doyouemo/antenna/README.md

# antenna
record how the PCB antenna draw
