doyouemo/antenna/Document/nrf52833_aoa_aod_hw_design.md

# nRF52833 BLE AoA/AoD 定位板 硬件设计文档

| 项目 | 内容 |
|---|---|
| 文档版本 | v0.1（初稿） |
| 日期 | 2026-08-10 |
| 状态 | 设计评审前 |
| 芯片 | NRF52833-QIAA（aQFN73, 7×7mm） |
| 方案 | BLE 5.1 CTE 方向定位，AoA/AoD 双角色 |

---

## 1. 项目概述

本板为基于 Nordic **nRF52833** 的蓝牙方向定位（Direction Finding）评估/产品板：

- 支持 **BLE 5.1 AoA（来波角度）**：作为定位基站，用 **3×4 = 12 单元天线阵列**测来波方向；
- 支持 **AoD（出射角度）**：同一射频链路切到发射模式，作为标签让对端（手机等）测出射方向；
- 调试/日志采用 **CH340N**（USB 转串口，内置晶振）提供独立 UART 日志口 + **RTT**（SEGGER，走 SWD）实时调试；
- 按 **Config 5** 参考电路设计：启用内部 DC/DC 省电、启用 nRF 内置 USB 与 NFC；
- nRF 内置 USB（D+/D−、VBUS/VDDH）与 NFC（NFC1/NFC2）引脚**引出到排针/测试点**，便于后续使用。

## 2. 设计指标

| 项目 | 指标 | 备注 |
|---|---|---|
| 协议 | BLE 5.1，支持 CTE | 2.4GHz |
| 方向定位 | AoA / AoD 双角色 | 固件模式切换 |
| 天线阵列 | 3×4 微带贴片，12 单元 | 中心距 ≈ 半波长 ≈ 61mm |
| CTE 采样 | 4 MHz I/Q 采样 | 每天线 1µs 采样 |
| 天线切换 | 1µs 切换 + 1µs 采样 | RF 开关切换时间 < 1µs |
| 日志/调试 | CH340N UART + RTT(SWD) | 详见 §12 |
| 供电 | USB 5V → 3.3V | 可选电池 + 内部 DCDC |
| 工作电压 | 1.7–3.6V（VDD） | |

## 3. 系统框图

```
                    ┌──────────────────────────────┐
                    │    3 × 4 微带贴片阵列（12）    │
                    │    中心距 61mm（≈λ/2）        │
                    └───┬────┬────┬────┬──────────┘
                        │    │    │    │   12 根馈线(等长/相位对齐)
                 ┌──────┴───┐ ┌──┴────┐
                 │ SP4T ×3  │ │ ……     │   第一级开关（3×SP4T）
                 └──────┬───┘ └───┬───┘
                        │   3 路合并 │
                    ┌───┴───────────┴───┐
                    │     SP4T ×1        │   第二级开关
                    └─────────┬─────────┘
                              │ ANT (H23)
                      ┌───────┴───────┐
                      │   nRF52833     │
                      │  (QIAA/aQFN73) │
                      └──┬────┬────┬──┘
                         │    │    │
            ┌────────────┘    │    └────────────┐
            │  SWD(RTT)     3.3V        UART TX/RX
        ┌───┴───┐      ┌────┴────┐      ┌──────┴──────┐
        │ J-Link│      │ 电源 DCDC │      │   CH340N    │
        │烧录+RTT│     │ →3.3V   │      │  (USB-UART)  │
        └───────┘      └─────────┘      └──────┬──────┘
                                               │
                                        USB-C 调试/日志口
```

## 4. 总体架构

- **射频路径**：ANT(H23) → 两级 RF 开关树 → 12 个贴片阵元。天线切换由 nRF 的 **PPI + GPIOTE + TIMER** 硬件时序驱动（与 CTE 时隙对齐），不占用 CPU。
- **数字路径**：nRF52833 的 UARTE 接 CH340N，CH340N 经 USB-C 输出虚拟串口；SWD 接 J-Link 用于烧录与 RTT；nRF 内置 USB（D−/D+）与 NFC 引脚引出备用。
- **角色切换**：同一硬件，固件按模式配置芯片为 CTE 接收（AoA locator）或 CTE 发射（AoD transmitter）。

## 5. 主要器件选型

| 器件 | 推荐型号 | 说明 |
|---|---|---|
| MCU | **nRF52833-QIAA-R** | aQFN73，BLE 5.1 DF |
| USB 转串口 | **CH340N** | SOP-8，内置晶振，3.3V 供电 |
| RF 开关(SP4T) | **SKY13322-375LF**（或等效） | 4 选 1，切换时间 ~几十 ns |
| RF 开关(SPDT 备用方案) | SKY13351-378LF | 全 SPDT 树方案时用 |
| 32MHz 晶振 | 标准 32MHz，±10ppm | XC1/XC2 |
| 32.768kHz 晶振 | 标准 32.768kHz，±20ppm | P0.00/P0.01，**必须接** |
| 电源 DCDC | **TPS62742**（TI） | 5V→3.3V，低静态电流 |
| USB 连接器 | USB Type-C（仅 USB2.0 信号） | 调试/日志口 |
| ESD 保护 | USBLC6-2SC6 | USB D+/D− |
| 内部 DCDC 电感 | **L3 = 10µH**（DCC 脚） | Config 5 启用内部 DC/DC |
| 内部 DCDC 滤波 | **L4 = 15nH、C15 = 47nF、C20 = 4.7µF** | DC/DC 相关滤波 |
| NFC 调谐电容 | Ctune1 / Ctune2（天线决定） | NFC 天线匹配 |

> 选型说明：RF 开关具体型号以现货与规格书为准，重点是**切换时间 < 1µs**、插损小、2.4GHz 性能好。

## 6. 原理图设计要点

### 6.1 nRF52833 电源与去耦

- **VDD**：3.3V，就近放 100nF + 10µF 去耦。
- **DCC**（B3）：内部 DC/DC 开关节点，接 **L3 = 10µH 电感**到 VDD。固件使能 DCDCEN（Config 5）。
- **DEC1/DEC3/DEC5**：稳压器去耦电容（100nF 级）。
- **DEC4(B5) 与 DEC6(E24)**：**必须用走线连在一起**，各放去耦电容。
- **VDDH(Y2)**：**接 VBUS(5V)**——启用 nRF 内置 USB 时，VBUS 必须接 VDDH 供 USB 稳压器（2.5–5.5V）。
- **DECUSB(AC5)**：USB 3.3V 稳压器去耦，接去耦电容到地（Config 5 USB 启用）。
- **VSS_PA(F23)**：射频地，就近打孔到主地。
- **底部焊盘**：必须接地。

> 具体电容数值**以规格书 “Supply pin decoupling” 表为准**，本表为典型参考值。

### 6.2 晶振

- **32MHz**：XC1/XC2 接 32MHz 晶振，负载电容按晶振 datasheet（典型 2×10~12pF）。
- **32.768kHz**：P0.00( XL1) / P0.01( XL2) 接 32.768kHz 晶振，负载电容典型 2×12pF。**必须接**（BLE 时序 + DF 功耗，见 §14）。
  - 占用 P0.00/P0.01，不能当 GPIO 用。

### 6.3 天线与 RF 开关树

两级 SP4T 树，实现 **1-of-12** 选择：

```
第一级:  3 × SP4T   → 每个开关接 4 个阵元（共 12）
第二级:  1 × SP4T   → 3 路第一级输出选 1（用 4 口中 3 口）
控制线:  3×2 + 2 = 8 根 GPIO
```

- 控制线接 nRF GPIO（见 §7），由 **PPI/GPIOTE 硬件**按 CTE 时序翻转。
- **ANT(H23) → 开关树**之间为 50Ω 走线。
- 开关供电电压要与控制电平匹配（典型 3.3V/1.8V，看型号）。

### 6.4 CH340N 串口电路

```
USB-C ──D+ ──22Ω/ESD── CH340N UD+
       └─D− ──22Ω/ESD── CH340N UD−
5V VBUS ──────────────→ DCDC → 3.3V → CH340N VCC
CH340N RXD ←── nRF TXD (P0.08)
CH340N TXD ──→ nRF RXD (P0.11)
CH340N RTS#/DTR# : 悬空（本板不需要自动复位/下载）
```

- CH340N **内置晶振**，无需外接晶振与负载电容。
- CH340N 3.3V 供电，I/O 电平 3.3V，与 nRF 直连。
- D+/D− 加 **22Ω 串联**和 **ESD 保护**。

### 6.5 SWD 调试接口（RTT）

- 引出 **SWDIO + SWDCLK + VDD + GND**（建议标准 4-pin 或 10-pin 排针）。
- 建议同时引出 **P0.18/nRESET**（复位与全功能调试）和 **P1.00/SWO**（可选）。
- RTT 复用 SWDIO/SWDCLK，烧录与 RTT 可同时使用。

### 6.6 复位、按键、LED

- **nRESET**：上电复位电路（RC 复位 + 调试器复位可选）。
- **按键**：P0.13，用于角色切换（AoA/AoD）或配置。
- **LED×2**：P0.05 / P0.06 状态指示。

### 6.7 nRF 内置 USB（引出）

- **D−（AD4）/ D+（AD6）**：引出到排针/测试点（后续可接第二个 USB 连接器）。
- **VBUS（AD2）/ VDDH（Y2）**：VDDH 接 VBUS(5V)，从引出的 VBUS 测试点取电或跳线接主 5V。
- **DECUSB（AC5）**：接去耦电容。
- 与 CH340N 的 USB 相互独立，两者可共存。

### 6.8 NFC（引出）

- **NFC1（P0.09）/ NFC2（P0.10）**：接 NFC 天线，引出至焊盘/排针。
- 天线端加 **Ctune1/Ctune2 调谐电容**（值随天线定）。
- 启用 NFC 后 P0.09/P0.10 不可当 GPIO。

## 7. 引脚分配表

| 功能 | 引脚 | 方向 | 说明 |
|---|---|---|---|
| 32.768kHz 晶振 | P0.00 / P0.01 | — | XL1/XL2，专用 |
| 32MHz 晶振 | XC1 / XC2 | — | 专用 |
| ANT | H23 | RF | 射频口 → 开关树 |
| SW_A0 / SW_A1 | P0.27 / P1.08 | O | SP4T-1 控制（高速脚） |
| SW_B0 / SW_B1 | P0.04 / P1.09 | O | SP4T-2 控制（高速脚） |
| SW_C0 / SW_C1 | P0.26 / P1.07 | O | SP4T-3 控制 |
| SW_D0 / SW_D1 | P0.24 / P0.23 | O | SP4T-4（第二级）控制 |
| UART_TX | P0.08 | O | → CH340N RXD |
| UART_RX | P0.11 | I | ← CH340N TXD |
| SWDIO / SWDCLK | AC24 / AA24 | I/O | 烧录 + RTT |
| nRESET | P0.18 | I | 复位（可选引出） |
| SWO | P1.00 | O | 调试跟踪（可选） |
| LED1 / LED2 | P0.06 / P0.05 | O | 状态灯 |
| 按键 | P0.13 | I | 角色切换/配置 |
| NFC1 / NFC2 | P0.09 / P0.10 | — | **NFC 天线**（引出）；启用 NFC 后不可当 GPIO |
| USB D− / D+ | AD4 / AD6 | — | nRF 内置 USB（引出，专用脚） |
| VBUS / VDDH | AD2 / Y2 | — | nRF USB 电源：VDDH 接 VBUS(5V) |

**未分配/可用 GPIO（预留）**：P0.02, P0.03, P0.07, P0.12, P0.14–P0.17, P0.19–P0.22, P0.25, P0.28–P0.31(AIN), P1.01–P1.06。

## 8. 天线阵列设计

- **类型**：微带贴片天线（PCB 蚀刻），3 列 × 4 行。
- **中心距**：≈ 半波长 ≈ **61mm**（2.44GHz），两方向一致。
- **阵元尺寸**：约 30mm 见方（取决于板材 εr/厚度，**以仿真为准**）。
- **地平面**：贴片下层必须**完整地平面**，天线区禁止铺铜开槽/走线/器件。
- **馈电**：每阵元边缘馈电，50Ω 馈线引出；**12 根馈线等长、对称**，避免引入额外相位差。
- **隔离度**：阵元间尽量 >10dB，必要时用过孔墙/地槽。
- **阵列占板**：含地缘约 **170mm × 230mm** 以上，建议独立天线板与主控分板，或单大板。

## 9. 电源设计

- **输入**：USB 5V（来自调试口 VBUS）或外部 3.3V。
- **5V → 3.3V**：TPS62742 DCDC，输出 3.3V 供 nRF VDD、CH340N 及开关。
- **内部 DCDC（Config 5）**：DCC 接 **L3 = 10µH** 电感到 VDD，固件使能 DCDCEN，降低 3.3V→1.3V 降压损耗。
- **电池模式（可选）**：电池直供 VDD（1.7–3.6V）；3.3V LDO 供 CH340N 或断电。
- 各 DEC/VDD 去耦就近放置。

## 10. PCB 布局与叠层

**叠层（4 层）**：

| 层 | 用途 |
|---|---|
| L1 | 信号（贴片天线、走线） |
| L2 | 完整地平面 |
| L3 | 电源/地分割 |
| L4 | 信号/背面 |

- 天线区置于板边/独立板，**正反面净空**，地缘完整。
- ANT→开关→馈线全部 **50Ω 阻抗**（L1 到 L2 参考，注意线宽/间距）。
- 开关树靠近 ANT 与阵列馈电点，减少走线长度。
- 晶振、DCDC、RF 部分各自就近地，避免开关电源噪声串入射频。
- 8 根开关控制线从 nRF 到开关，尽量等长、短走线。

## 11. 调试与日志方案

| 手段 | 用途 | 说明 |
|---|---|---|
| **RTT** | 实时日志、时序敏感打印 | 走 SWD，需 J-Link；开发阶段主力 |
| **CH340N UART** | 独立串口日志 | 不依赖 nRF 固件/USB 驱动，崩溃时仍可出日志 |

日志输出建议：
- 开发期：RTT 打印 AoA 采样、角度、状态机；
- 联调期：CH340N UART（115200 或 1Mbps）输出结构化日志。

## 12. BOM 清单（关键件）

| 序号 | 器件 | 型号 | 数量 | 备注 |
|---|---|---|---|---|
| 1 | MCU | nRF52833-QIAA-R | 1 | |
| 2 | USB-UART | CH340N | 1 | SOP-8 |
| 3 | RF 开关 | SP4T（如 SKY13322-375LF） | 4 | 或 SPDT 树方案 |
| 4 | 晶振 32MHz | ±10ppm | 1 | |
| 5 | 晶振 32.768kHz | ±20ppm | 1 | 必须 |
| 6 | DCDC | TPS62742 | 1 | 5V→3.3V |
| 7 | USB-C | Type-C 连接器 | 1 | USB2.0 信号 |
| 8 | ESD | USBLC6-2SC6 | 1 | USB D+/D− |
| 9 | DC/DC 电感 | 10µH（L3） | 1 | DCC→VDD |
| 10 | DC/DC 滤波 | 15nH（L4）+ 47nF（C15）+ 4.7µF（C20） | 各 1 | Config 5 |
| 11 | NFC 调谐 | Ctune1 / Ctune2 | 2 | NFC 天线匹配 |
| 12 | 天线 | PCB 贴片 | 12 | 板载蚀刻 |

## 13. 风险与注意事项

1. **板载阵列相位一致性**是最大风险：依赖蚀刻公差、地平面、互耦。**必须做阵列相位校准**（nRF 有校准例程），量产建议按批校准。
2. **P0.09/P0.10 用作 NFC**：启用 NFC 后不能当 GPIO；日后若要改当 GPIO，需在 UICR 配置 `NFCPINS` 禁用。
3. **32.768kHz 晶振不能省**：LFRC（内置 RC，±250ppm）会导致 BLE 时序超标、DF 监听功耗大幅上升。
4. **开关树 8 根控制线的时序**：由 PPI/GPIOTE/TIMER 硬件翻转，1µs 切换 + 1µs 采样的时序余量务必在固件侧验证。
5. **DECUSB / VDDH**：Config 5 USB 启用，DECUSB 去耦按规格书接好；**VDDH 必须接 VBUS**，漏接会导致 USB 稳压器无法工作。
6. **贴片尺寸与间距需仿真**：文档中为典型参考，最终以 HFSS/CST 仿真与实物校准为准。

## 14. 后续工作

- [ ] 细化 RF 开关选型（现货、插损、控制电平）
- [ ] 阵列贴片天线仿真（尺寸、间距、隔离度）
- [ ] 完成原理图（基于本文档 §6/§7）
- [ ] PCB 布局与阻抗控制（§10）
- [ ] 固件：nRF Connect SDK `direction_finding_connectionless` 示例验证
- [ ] 验证 nRF 内置 USB（CDC）与 NFC 功能
- [ ] 阵列相位校准流程建立
