doyouemo/antenna/Document/Design of Inset Microstrip Patch Antenna for Wireless Power Transmission at 2.45 GHz.pdf

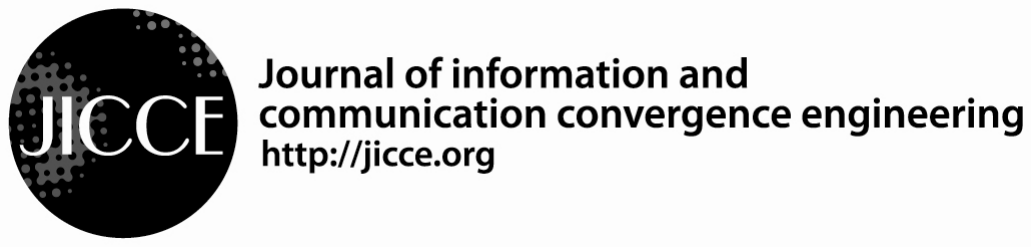
[picture p1: figure]

123

### I. INTRODUCTION

Wireless communication has been developed rapidly in the past decades and it already has a great impact on human life. In the field of wireless communications, antennas play a vitally important role. In the late 1970s, there was rapid development in the field of microstrip patch antenna technology. In early 1980s, antenna elements and arrays were developed in terms of design and modeling. Due to their advantages like light weight, reduced size, low cost, conformability, and the ease of integration with an active device, these antennas have been extensively studied. A microstrip patch antenna is the combination of a radiating patch on one side of the dielectric substrate and ground on the other side. The patch is generally made of a conducting material like gold or copper. The radiating patch and the feed lines are usually photo etched on the dielectric substrate. Microstrip patch antennas radiate primarily because of the fringing fields between the patch edge and the ground plane. Therefore, the antenna can be fed by a variety of methods. These methods can be classified into two categories: contacting and non-contacting. In the contacting method, the radio frequency (RF) power is fed directly to the radiating patch using a connecting element such as a microstrip line or probe feed. In the non-contracting method, electromagnetic field coupling is performed to transfer power between the microstrip line and the radiating patch which includes proximity feeding and aperture feeding [1, 2].
Microstrip antennas are characterized by a large number of physical parameters. They are designed to have many geometrical shapes and dimensions but rectangular and circular microstrip patches have been used in many applications. In this paper, the design of an inset feed rectangular microstrip patch antenna at 2.45 GHz for wireless communication is presented having length L, patch
J. lnf. Commun. Converg. Eng. 10(2): 123-128, Jun. 2012 | Regular Paper

# Design of Inset Microstrip Patch Antenna for Wireless Power Transmission at 2.45 GHz

Sajina Pradhan¹

, Sun-Kuk Noh²

, and Dong-You Choi¹*

1
Department of Information and Communication Engineering, Chosun University, Gwangju 501-759, Korea 2
Department of Electronics Engineering, Chosun University, Gwangju 501-749, Korea

### Abstract

In communication systems, there are various types of microstrip antenna that can be used for many applications. This paper mainly focuses on the simple design of an inset rectangular microstrip patch antenna to operate at a frequency of 2.45 GHz for rectenna design. The study involves using an high frequency structure simulator to design the antenna dimensions and to determine its performance. This antenna is based on a thickness of 1.6 mm flame retardant 4 (FR-4) substrate having a dielectric constant of approximately 4.7, an inset feed, and a ground plane. After simulation, the antenna performance characteristics such as its return loss, voltage standing wave ratio, gain, and radiation pattern were obtained and compared with the fabricated measured antenna.

Index Terms: Microstrip patch antenna, Inset feed technique, Radiation pattern, Wireless communication

___________________________________________________________________________________________

Received 06 March 2012, Revised 06 April 2012, Accepted 09 April 2012
*Corresponding Author E-mail: dychoi@chosun.ac.kr
http://dx.doi.org/10.6109/jicce.2012.10.2.112 | print ISSN:2234-8255 online ISSN:2234-8883

This is an Open Access article distributed under the terms of the Creative Commons Attribution Non-Commercial License (http://creativecommons.org/li-censes/by-nc/3.0/) which permits unrestricted non-commercial use, distribution, and reproduction in any medium, provided the original work is properly cited.

Copyright ⓒ The Korea Institute of Information and Communication Engineering

Open Access

J. lnf. Commun. Converg. Eng.10(2): 123-128, Jun. 2012

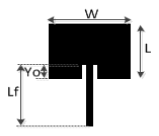
[picture p2: figure]

http://dx.doi.org/10.6109/jicce.2012.10.2.123 | 124

width W, inset fed distance Yo, and transmission line length Lf, as shown in Fig. 1. This antenna is designed on flame retardant 4 (FR-4) substrate and its performance characteristics, which include return loss, voltage standing wave ratio (VSWR), gain, and radiation pattern, were obtained from a simulation.

Fig. 1. Inset rectangular microstrip patch antenna.

### II. ANTENNA GEOMETERY AND ITS DESIGN REQUIREMENTS

For a rectangular patch, the length L of the patch is usually 0.333 λο , where λο is the free space wavelength. The patch is selected to be very thin, such that the height of the substrate h << λο . Thus, a rectangular patch of dimensions 36.26 × 27.90 mm is positioned on one side of an FR-4 substrate of thickness 1.6 mm, and the ground plane with dimension of 150 × 150 mm is located on the other side of the substrate.
There are three essential parameters for the design of an inset fed rectangular patch antenna. They are resonant frequency (fr), dielectric material of the substrate (εr), and the thickness of the substrate. The resonant frequency selected for this design is 2.45 GHz.
The dielectric material of the substrate selected for this design is FR-4, which has a dielectric constant of the 4.7 and a loss tangent equal to 0.019. The dielectric constant of the substrate material is an important design parameter. A low dielectric constant of the substrate material is used in the prototype design because it gives better efficiency, a higher bandwidth, and a low quality factor Q. The low value of the dielectric constant increases the radiated power. The design has a patch size independent of the dielectric constant. Therefore, the reduction in the patch size is accomplished by using a higher dielectric constant and FR-4 is good in this agreement. The small loss tangent was neglected in the simulation.
The thickness of the substrate is another important design parameter. The thickness of the substrate increases the fringing field at the patch periphery like the low dielectric constant and increases the radiated power. The height of the dielectric substrate of the inset microstrip patch antenna is h = 1.6 mm.

### III. MATHEMATICAL CALCULATION OF THE ANTENNA PARAMETERS

The parameters of the antenna can be calculated by the transmission line method.

### A. Width of the Patch

The width of the antenna can be determined by

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
⎛ + = W | r λο ε | (1)

### B. Length of the patch

The effective constant can be obtained by

2

1
12 1

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
⎛ − +⎟
⎟
⎠

⎞ ⎜
⎜
⎝

⎛ + =

W

h

r | r eff
ε | ε
ε | (2)

where
eff ε = elective dielectric constant
r ε = dielectric constant of substrate
h = height of dielectric substrate
W = width of the patch

The dimensions of the patch along its length have n ow been extended on each end by a distance ΔL , whic h is given by
( | )
( | ) | ⎟ ⎠
⎞ ⎜
⎝
⎛ − | +

⎟
⎠

⎞ ⎜
⎝

⎛ + +
Δ =
0.258 | 0.8
0.3 | 0.264
0.412
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
The actual length L of the patch is given by

L
f

L

r | eff
= | − 2Δ
2

1
ε

(4)

Where fr is the resonance frequency.

### C. Inset Feed

The inset feed introduces a physical notch, which in

Design of Inset Microstrip Patch Antenna for Wireless Power Transmission at 2.45 GHz

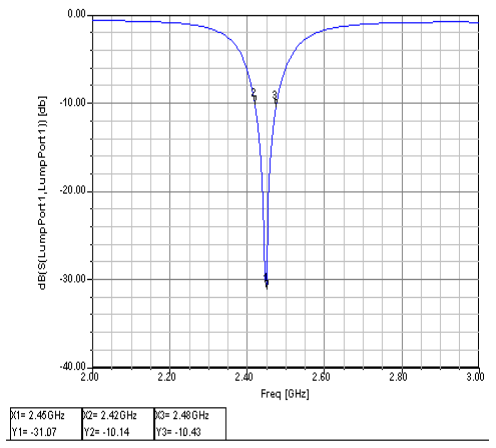
[picture p3: figure]
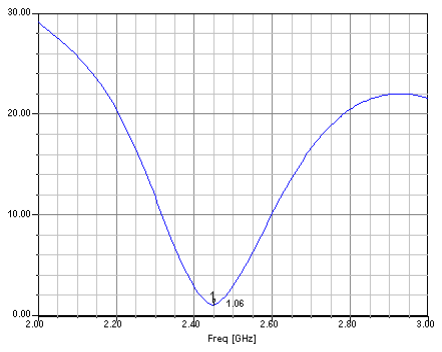
[picture p4: figure]

125 | http://jicce.org

turn introduces a junction capacitance. The physical notch and its corresponding junction capacitance influence the resonance frequency. As the inset feed-point moves from the edge toward the center of the patch, the resonant input impedance decreases monotonically and reaches zero at the center. When the value of the inset feed point
approaches the center of the patch, | 0 2 | y L
Cos Π | where 0 y

is the inset distance, which varies very rapidly; therefore, the input resistance also changes rapidly with the position of the feed point. To maintain very accurate values, a close tolerance must be preserved [3-5]. In this paper, the value of the inset-fed distance 0 y is 7.5 mm and the length and width of the transmission line at 50 Ω are 32 mm and 3 mm, respectively.

### IV. SIMULATION AND MEASUREMENT RESULTS

The antenna was simulated in high frequency structure simulator (HFSS), which is a high performance full-wave electromagnetic (EM) field simulator for arbitrary 3D volumetric passive devices, with a Microsoft Windows graphical user interface. The antenna designed in the HFSS simulator is shown in Fig. 2.

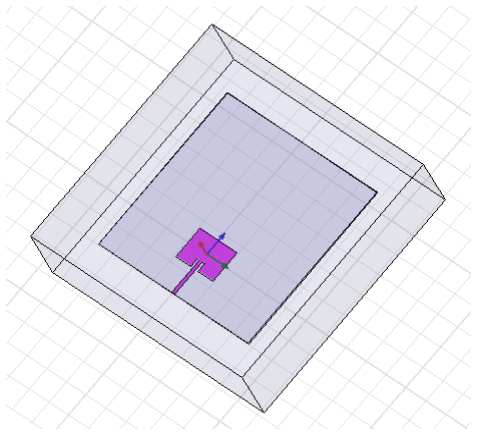
[picture p5: figure]

Fig. 2. Antenna in high frequency structure simulator.

The simulated return loss of the inset-fed antenna is -31.07 dB at the center frequency of 2.45 GHz as shown in Fig. 3.

The bandwidth of the antenna as a percentage is defined by

*100% max min
rf
f | f BW | − = | (5)

Fig. 3. Return loss vs. frequency.

where max f | and min f | are determined at -10 dB. rf is
the resonance frequency. The simulated value at -10 dB, max f = 2.48, min f = 2.42, and the bandwidth is 2.44%.
The VSWR characteristic of the antenna should fall in between 1 and 2. From simulation, its value is 1.06 at 2.45 GHz as depicted in Fig. 4.

Fig. 4. Voltage standing wave ratio vs. frequency.

Also, the radiation pattern of the antenna obtained is shown in Fig. 5 at phi = 90 degrees (red) and phi = 0 degrees (blue) at 2.45 GHz. This shows the gain of the antenna is 3.408 dB.

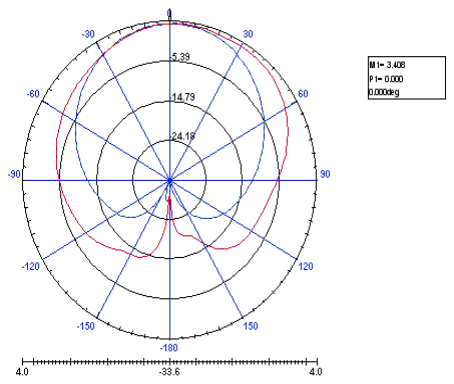
[picture p6: figure]

Fig. 5. Radiation pattern at 2.45GHz.

The scattering parameter for the antenna design at 2.45 GHz is shown in the Smith chart in Fig. 6.

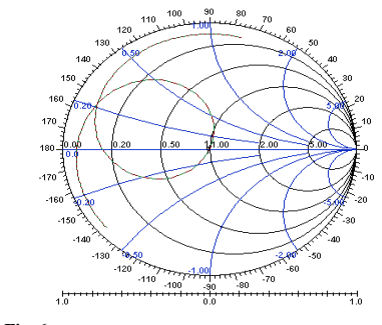
[picture p7: figure]

Fig. 6. Smith chart at 2.45 GHz.

The inset fed microstrip patch antenna is fabricated on a FR-4 printed circuit board (PCB) and the measurement setup is done by using an Agilent Technologies (Santa Clara, CA, USA) N5230A 10 MHz - 40 GHz PNA-L-Network Analyzer as shown in Fig. 7.

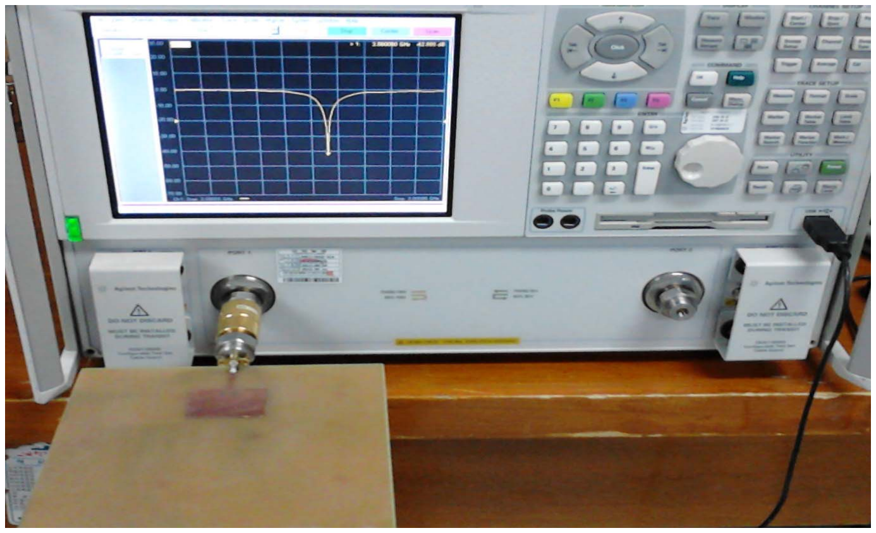
[picture p8: figure]

Fig. 7. Measurement setup of inset fed patch antenna.

The measured return loss is obtained to be -30.551 dB at 2.56 GHz as shown in Fig. 8 and impedance match at 50 Ω is shown in Fig. 9. The VWSR was measured with an Agilent Technologies N9912A found to be 1.02 at 2.548 GHz as shown in Fig. 10.

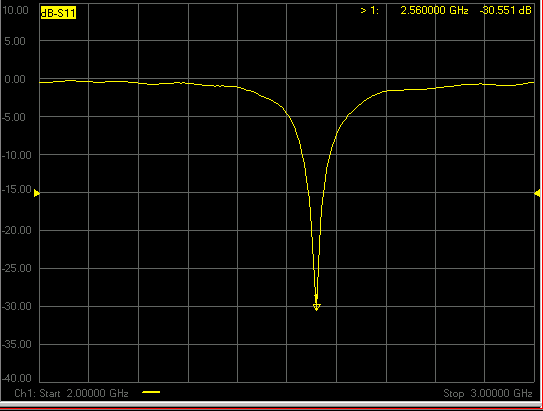
[picture p9: figure]

Fig. 8. Measured return loss vs. frequency.

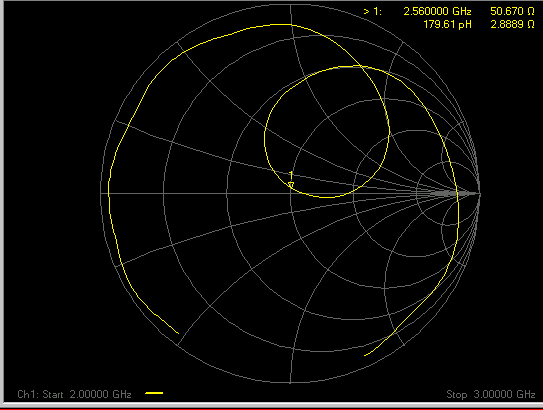
[picture p10: figure]

Fig. 9. Impedance matching at 50 Ω.

Design of Inset Microstrip Patch Antenna for Wireless Power Transmission at 2.45 GHz

127 | http://jicce.org

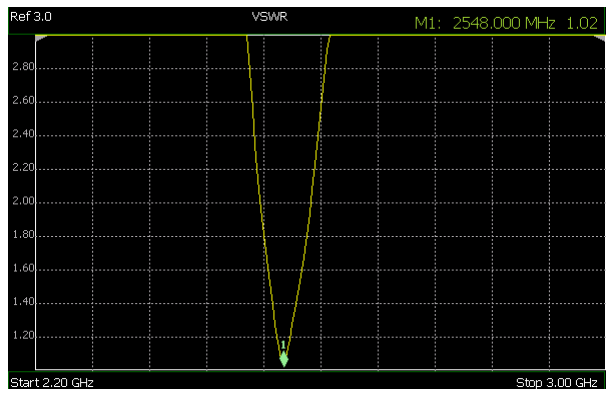
[picture p11: figure]

Fig. 10. Measured high frequency structure simulator (VWSR) is found to be 1.02.

The resonant frequency shifted from the designed frequency of 2.45 GHz. The reason for the shift may be due to the FR4 board. In the physical design of the antenna, a material having varying εr, length, width, and thickness of the board may cause shifting of the resonant frequency. Other factors may also have an effect, such as the chemical used in etching accuracy and the surface finish. The difference between the simulated and fabricated measured value is shown in Table 1.

Table 1. Comparison between simulation and fabricated measured results

Result | Resonant
| frequency (GHz) | Return loss
| | (dB) | VSWR
Simulation | 2.45 | -31.07 | 1.06
Measurement | 2.56 | -30.551 | 1.02

VWSR: high frequency structure simulator.

### V. CONCLUSIONS

In this paper, the mathematical calculation for design of an inset rectangular patch antenna at 2.45 GHz is presented. The simulation of an inset-fed microstrip patch antenna was
performed | in | HFSS. | The | antenna | performance
characteristics such as return loss, VSWR, gain, and radiation pattern were obtained in the simulation. The fabricated antenna frequency was compared with the simulated resonance frequency. It was found to be slightly different than the simulated value as real world physical parameters may not be exactly the same.

### REFERENCES

[1] C. A. Balanis, Antenna Theory: Analysis and Design, 2nd ed., New York, NY: John Wiley & Sons, 1997.
[2] D. M. Pozar, Microwave Engineering, 2nd ed., New York, NY: John Wiley & Sons, 1998.
[3] Y. Hu, D. R. Jackwon, J. T. Williams, and S. A. Long, “A design approach for inset-fed rectangular microstrip antennas,” Proceedings of IEEE Antennas and Propagation Society International Symposium, Albuquerque, NM, pp. 1491-1494, 2006.
[4] M. Ramesh and K. Yip, “Design formula for inset fed microstrip patch antenna,” Journal of Microwaves and Optoelectronics, vol. 3, no. 3, pp. 5-10, 2003.
[5] I. Surjati, K. N. Yuli, and A. Astasari, “Microstrip patch antenna fed by inset microstrip line for Radio Frequency Identification (RFID),” Proceedings of Asia-Pacific Symposium on Electromagnetic Compatibility, Beijing, China, pp. 1351-1353, 2010.

Sun Kuk Noh
received the B.Sc., the M.Sc., and the D.Sc. degrees in Electronics Engineering from Chosun University of Gwangju, Republic of Korea, in 1995, 1997, and 2000, respectively. From March 2002 to August 2004, he was a Research Professor in the Division of Electronics and Information Engineering, Chonbuk National University, Republic of Korea. Since Sept. 2004, he has been a Full-time Lecturer in the Department of Mobile Communications Engineering, Honam University, Gwangju, Korea. His major research interests include mobile communications, radiowave propagation, DMB, RFID, and USN. He is a Member of IEEE, JCN, IEEK, and KICS.

Sajina Pradhan,
received a B.E. degree in Electronics and Communication Engineering in Nepal in 2007. Since 2010, she has been a Master’s student in Communication and Wave Propagation Lab, Department of Information and Communication, Chosun University, Gwangju, South Korea. Her research areas of interest are RF Energy harvesting devices, designs, and applications.

Dong You Choi
received the B.S., M.S., and Ph.D. degrees in the Department of Electronic Engineering from Chosun University, Gwangju, Korea in 1999, 2001, and 2004, respectively. Since 2007, he has been teaching and researching as an assistant professor at Chosun University. His research interests include mobile communication and wave propagation. He is a member of IEICE, JCN, KEES, IEEK, and KICS.
