doyouemo/antenna/Hardware/PCA20054-Direction Finding Antenna Board 1_0_0/PCA20054-Direction Finding Antenna Board 1_0_0/Production files/PCB_LAMINATE_PARAMETERS/PCA20054 pcb laminate specification.pdf

## PCB Laminate Specification

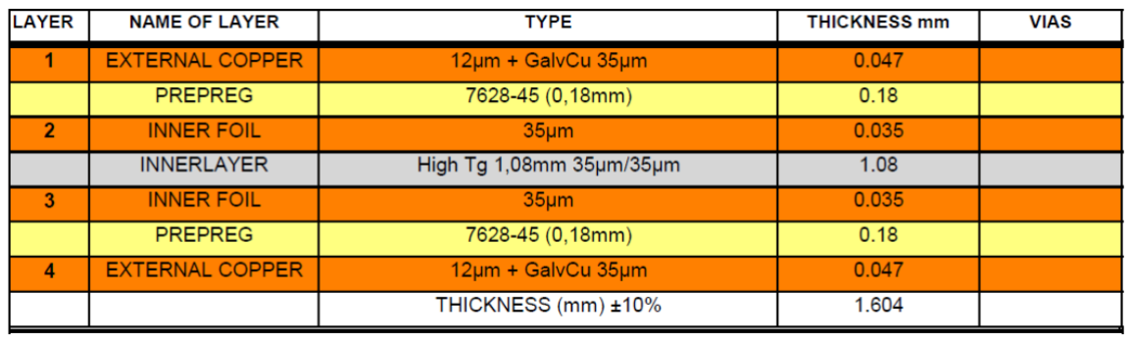
[picture p12: figure]

Template ID: 1159140_128 | Page 1 of 1 | Template rev. 1.2, 2017-03-27

## PCB laminate parameters

PCB Supplier | Suppliers choice
Number of copper layers | 4 layers
Laminate material | FR4
Total board thickness | 1.6mm
PCB stackup | See figure 1
Copper thickness | See figure 1
Solder Mask Color | Green
Silkscreen Color | White
Surface finish | ENIG Gold
Compliance with environmental directives | RoHS

### Table 1 PCB substrate details

The PCB layer stackup order (from top layer and down) shall be as follows with reference to the

### Gerber file extensions given below:

- | Top layer: | .GTL
- | Mid-layer 1: | .G1
- | Mid-layer 2: | .G2
- | Bottom Layer: | .GBL

### Figure 1: 4 layer stackup
