doyouemo/antenna/Hardware/PCA20054-Direction Finding Antenna Board 1_0_0/PCA20054-Direction Finding Antenna Board 1_0_0/Production files/BOM/PCA20054_BOM_Web.xlsx

Bill of material
Board: | PCA20054
Version: | 1.0.0
Designator | Value | Description | Assembly | Footprint Doc | Manufacturer | Manufacturer Part Number
C301, C304, C307, C310, C313, C402, C501 | 1.0µF | Capacitor, X7R, ±10% |  | 0603
C302, C303, C305, C306, C308, C309, C311, C312, C314, C315 | 100pF | Capacitor, NP0, ±5% |  | 0402
C316, C317, C318, C319, C320, C321, C322, C323, C324, C325 | N.C. | Not mounted | Not mounted | 0402
C326, C327, C328, C329 | 18pF | Capacitor, NP0, ±5% |  | 0402
C330, C331, C332, C333, C334, C335, C336, C337, C338, C339, C340, C341, C502 | 10nF | Capacitor, X7R, ±10% |  | 0402
C401, C403 | 4.7µF | Capacitor, X5R, ±10% |  | 0603
C404 | 2.2µF | Capacitor, X7R, ±10% |  | 0603
J1 | SMA Vertical | SMA Vertical connector |  | SMA-VERT
L301, L302, L303, L304 | 0.5nH | Inductor, 1A, ±0.1nH |  | 0402 | TDK Corporation | MLG1005S0N5BT000
L305, L306, L307, L308, L309, L310, L311, L312, L313, L314, L315, L316 | 2.4nH | Inductor, 220mA, ±0.1nH |  | 0402
L501 | 30nH | Inductor, 270mA, ±2%, 580mΩ, Q=25 |  | 0402 | Murata | LQW15AN30NG00
LED401 | L0603G | LED, Green, 0603, 570nm, Vf=1.7V, 2.24..5.6mcd, - 40 to +100°C |  | 0603 | Osram | LG L29K-G2J1-24-Z
P1, P3 | Socket 1x8 | Socket 1x8, 2.54mm (100mil), SMD |  | SOCKET_1x8_SMD | W-CON | 2171-108MS0CUNR1
P2 | Socket 1x6 | Socket 1x6, 2.54mm (100mil), SMD |  | SOCKET_1x6_SMD | W-CON | 2171-106MS0CUNR1
P4 | Socket 1x10 | Socket 1x10, 2.54mm (100mil), SMD |  | SOCKET_1x10_SMD | W-CON | 2171-110MS0CUNR1
P5 | Pin Hdr 2x3 | Pin Header 2x3, 2.54mm (100mil) SMD |  | HDR_2x3-SMD | W-CON | 1125-1203S0M116R1
P6 | Socket 1x9 | Socket 1x9, 2.54mm (100mil), SMD |  | SOCKET_1x9_SMD | W-CON | 2171-109MS0CUNR1
R301, R304, R307, R310, R313, R316, R319, R322, R325, R328, R331, R334, R401, R405, R505, R508 | 0R | Resistor, ±5%, 0.063W |  | 0402
R302, R305, R308, R311, R314, R317, R320, R323, R326, R329, R332, R335, R337, R338, R339, R340, R341, R342, R343, R344, R345, R346, R347, R348, R506, R507 | N.C. | Not mounted | Not mounted | 0402
R349, R350, R351, R352 | 100R | Resistor, ±1%, 0.063W |  | 0402
R402 | 220R | Resistor, ±1%, 0.063W |  | 0402
R403 | 86k6 | Resistor, ±1%, 0.063W |  | 0402 | Panasonic | ERJ-2RKF8662X
R404 | 51k1 | Resistor, ±0.1%, 0.063W |  | 0402 | Panasonic | ERA-2AEB5112X
R406 | 10k | Resistor, ±1%, 0.063W |  | 0402
R501, R502, R503, R504 | 1M0 | Resistor, ±1%, 0.063W |  | 0402
SW401 | PB SW | Tactile Switch, SPNO, SMD, 160gf, 6.2x6.3x2.5mm |  | Switch-PB-6.2x6.3mm-SMD | Dailywell | TS604VM1-025BR-R
U301, U302, U303, U304, U305 | PE42442 | UltraCMOS SP4T RF Switch 30 MHz-6 GHz |  | QFN-24 | Peregrine Semiconductors | PE42442
U401 | LM27761 | Low-Noise, Regulated, Switched-Capacitor Voltage Inverter |  | WSON-8 | Texas Instruments | LM27761
V301, V302, V303, V304, V305, V306, V307, V308, V309, V310, V311, V312, V501, V502, V503, V504, V505 | LXES15AAA1-133 | TVS DIODE 15VWM 0402 |  | 0402 | Murata | LXES15AAA1-133
