doyouemo/antenna/Hardware/PCA20054-Direction Finding Antenna Board 1_0_0/PCA20054-Direction Finding Antenna Board 1_0_0/Schematic_Layout pdf files/PCA20054_Schematic_And_PCB.pdf

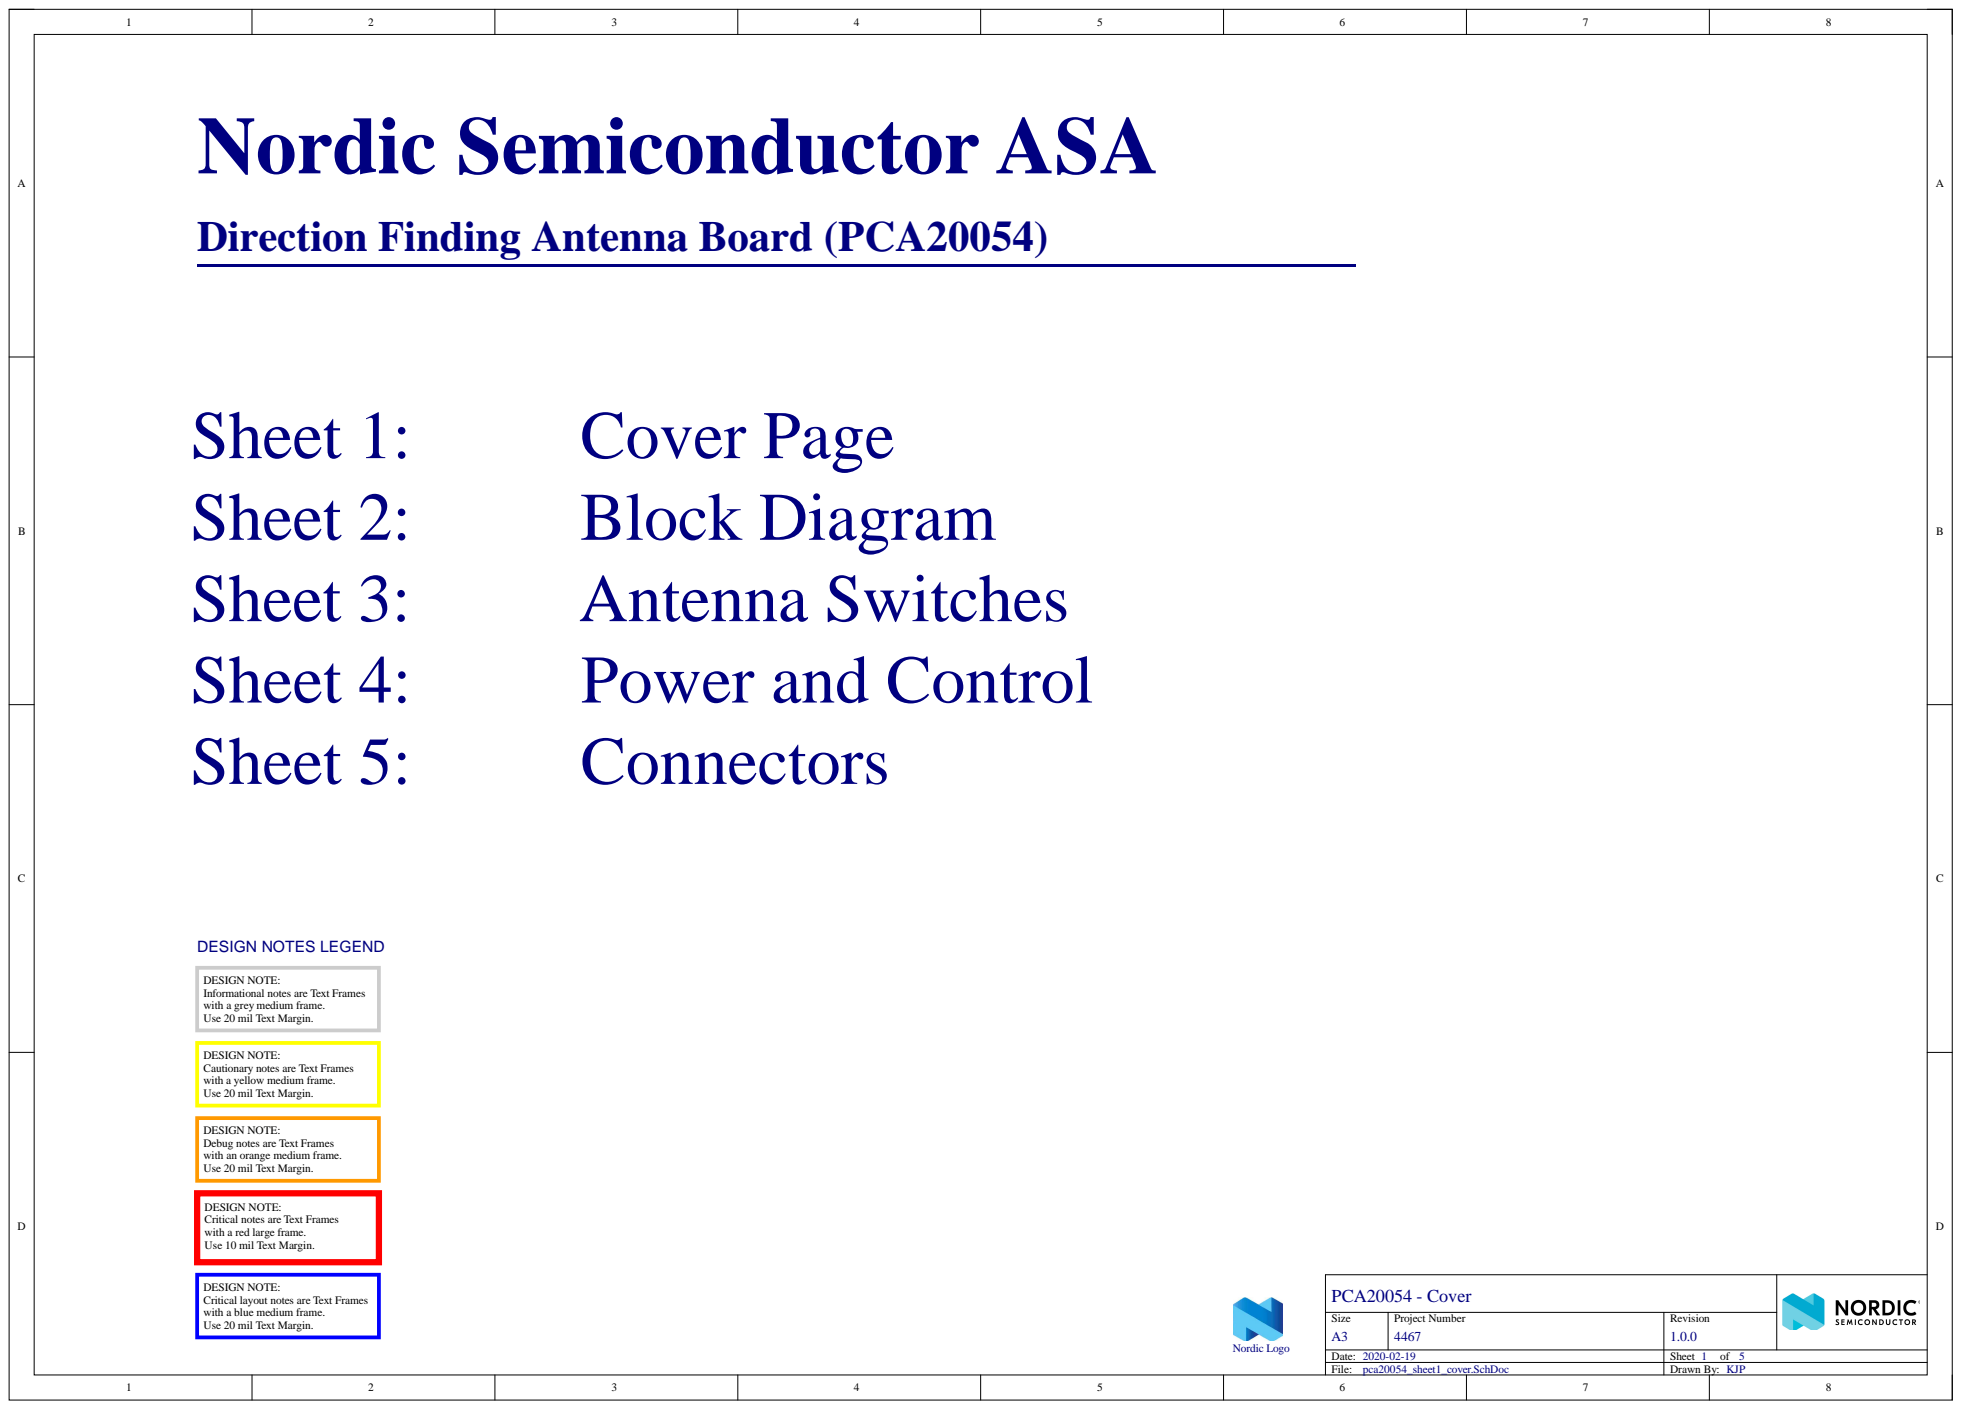
[picture p13: page 1]

_________________________________________ ection Finding Antenna Board (PCA20054)
Dir

DESIGN NOTE:
Informational notes are Text Frames
with a grey medium frame.
Use 20 mil Text Margin.

Cautionary notes are Text Frames
with a yellow medium frame.

Debug notes are Text Frames
with an orange medium frame.

Critical notes are Text Frames
with a red large frame.
Use 10 mil Text Margin.

Critical layout notes are Text Frames
with a blue medium frame.

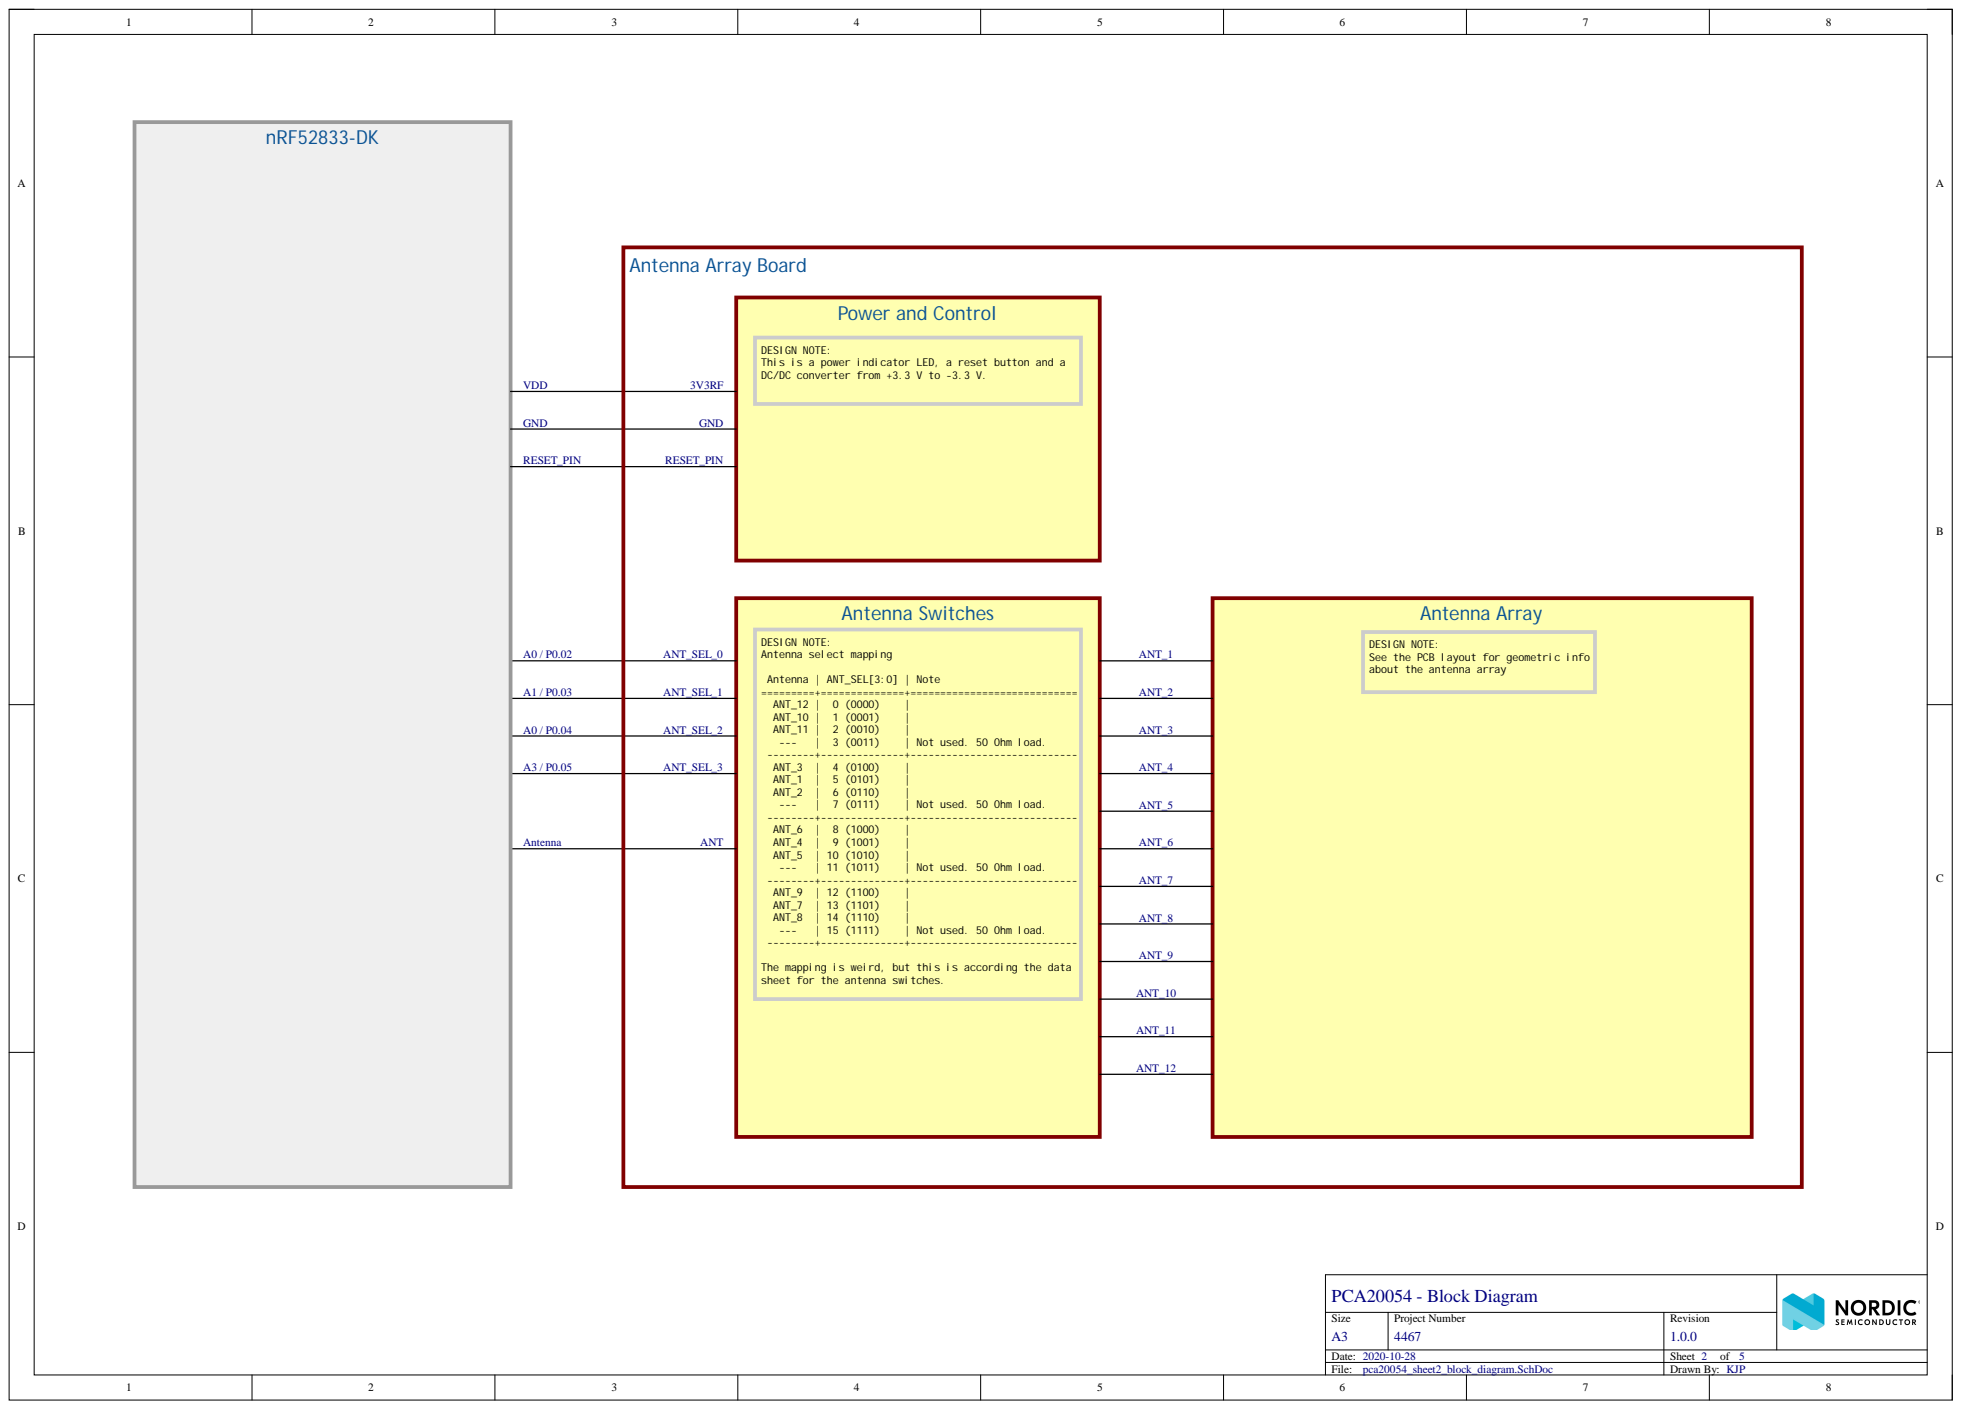
[picture p14: page 2]

Antenna Array Board

DESIGN NOTE:
This is a power indicator LED, a reset button and a
DC/DC converter from +3.3 V to -3.3 V.

GND | GND

RESET_PIN | RESET_PIN

See the PCB layout for geometric info
about the antenna array

The mapping is weird, but this is according the data
sheet for the antenna switches.

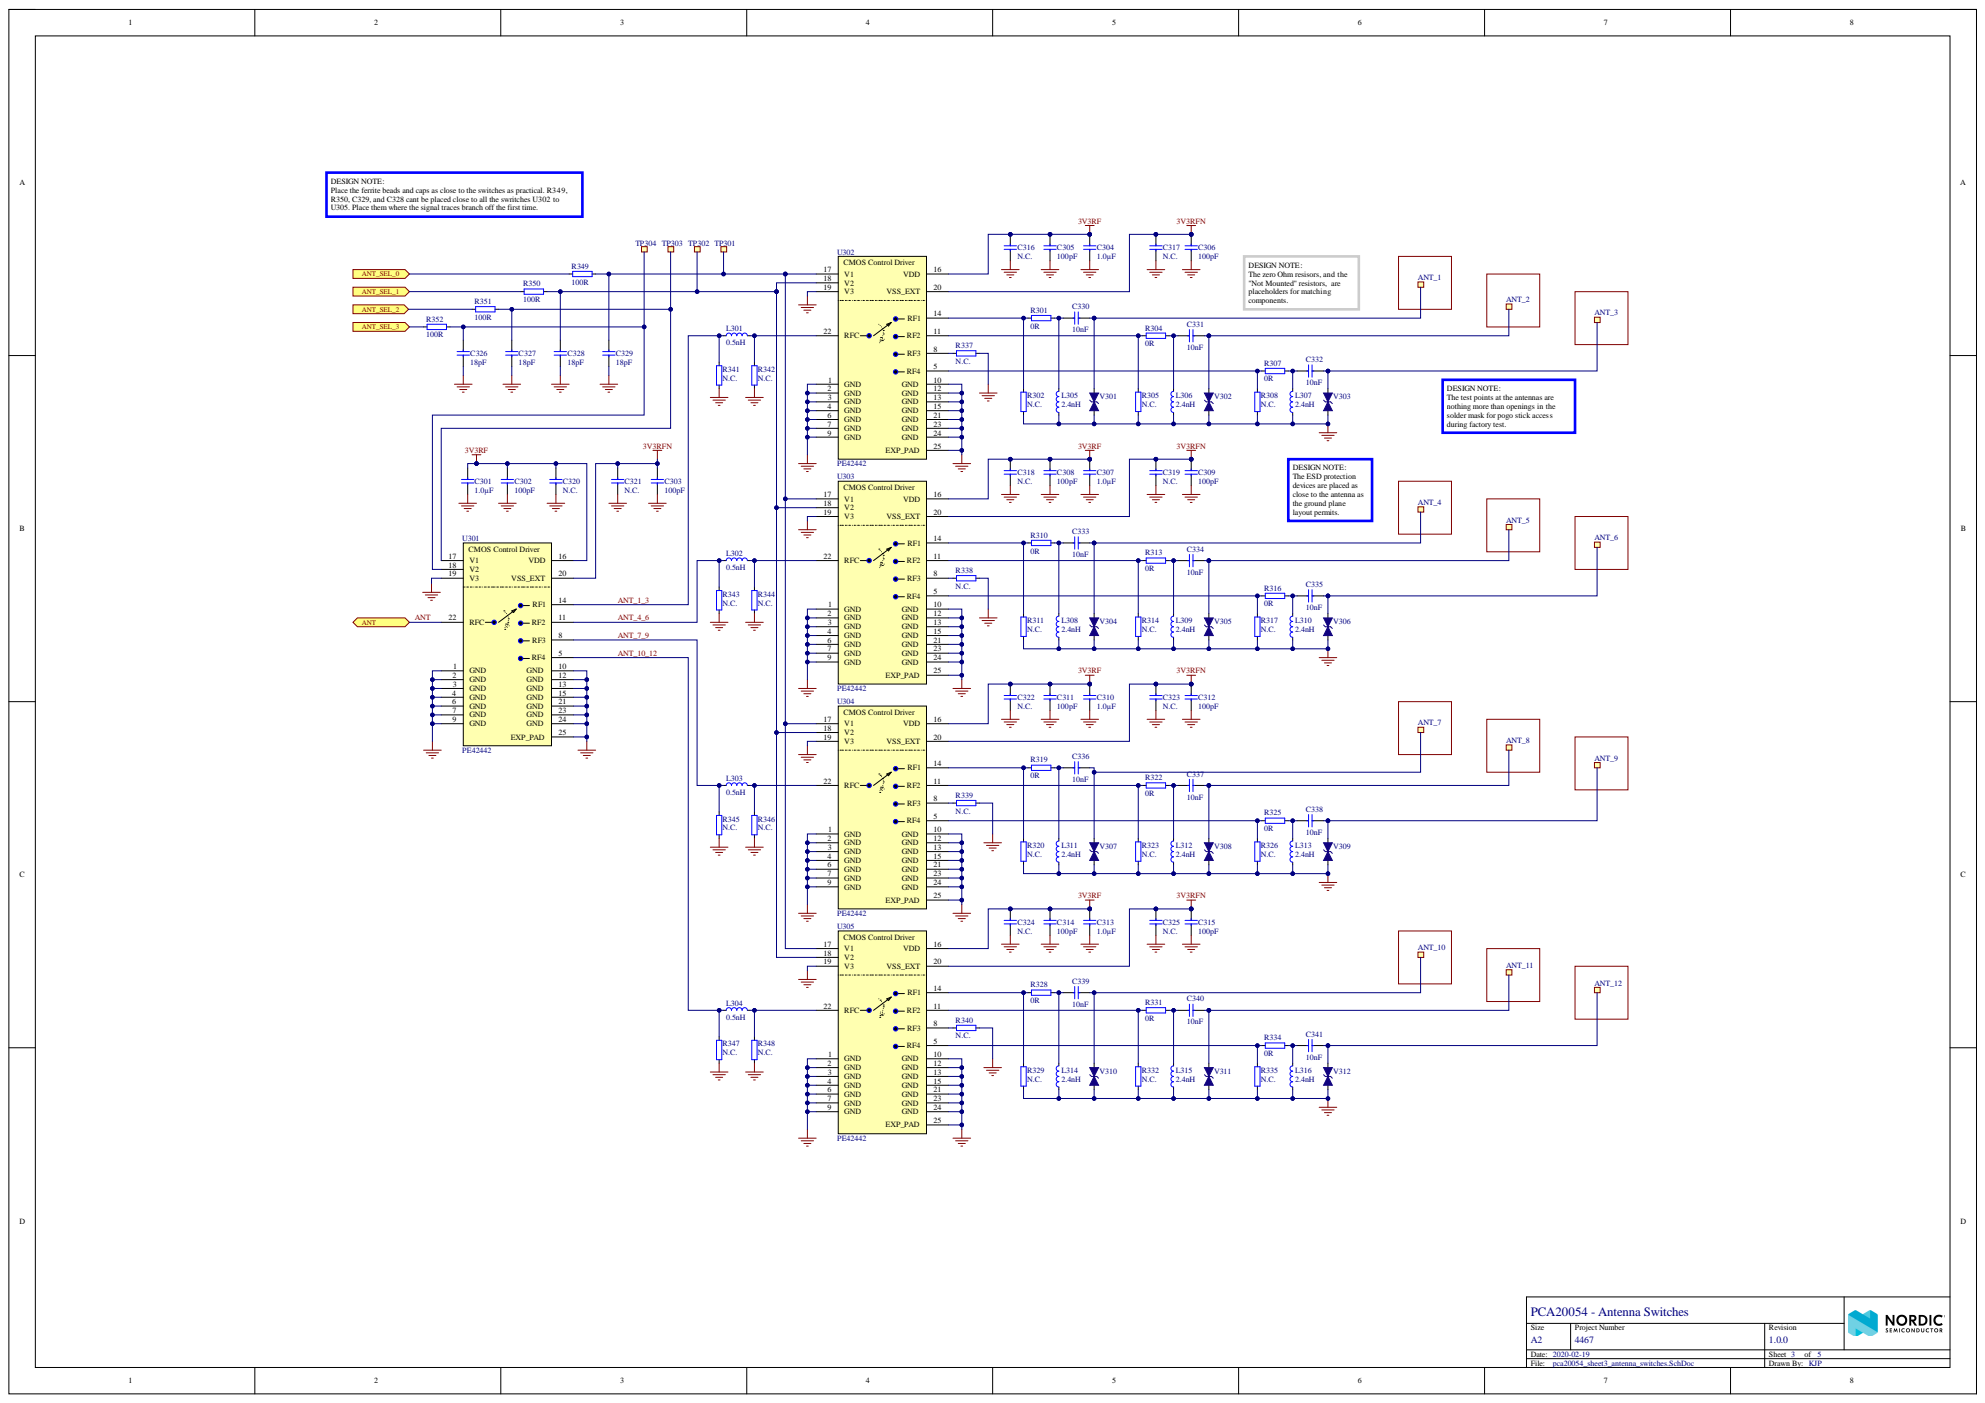
[picture p15: page 3]

DESIGN NOTE:
Place the ferrite beads and caps as close to the switches as practical. R349,
R350, C329, and C328 cant be placed close to all the swritches U302 to
U305. Place them where the signal traces branch off the first time.

The zero Ohm resisors, and the
"Not Mounted" resistors, are
placeholders for matching
components.

3 | 13
4 | 15
6 | 21
7 | 23
9 | 24

The test points at the antennas are
nothing more than openings in the
solder mask for pogo stick access
during factory test.

The ESD protection
devices are placed as
close to the antenna as
the ground plane
layout permits.

ANT_7_9 | 3 4 | 13 15

2 | 12

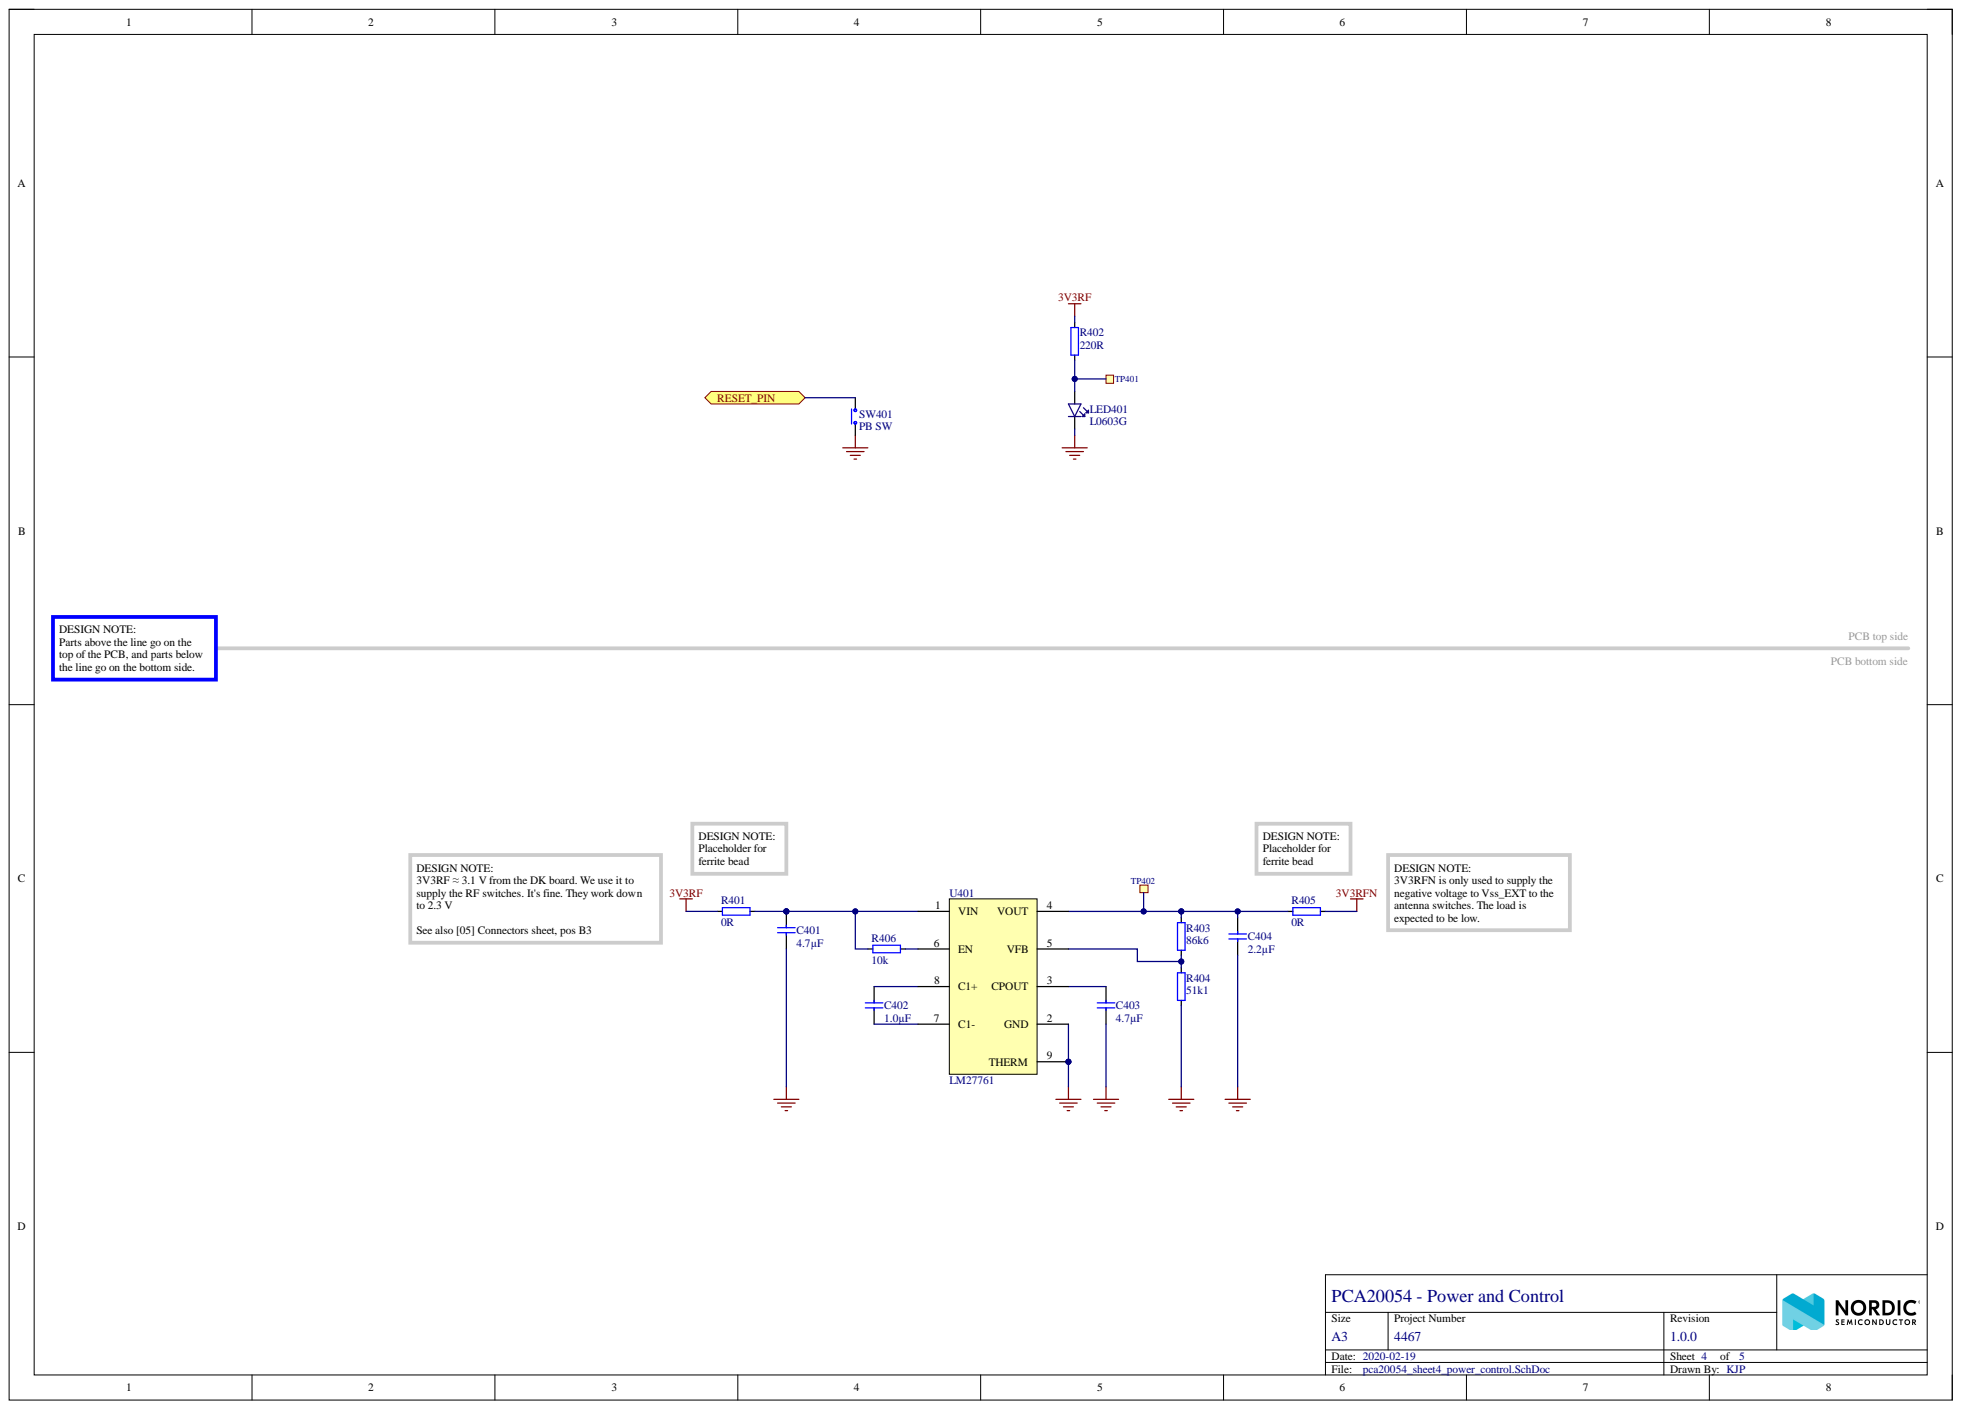
[picture p16: page 4]

DESIGN NOTE:
Parts above the line go on the
top of the PCB, and parts below

3V3RF ≈ 3.1 V from the DK board. We use it to
supply the RF switches. It's fine. They work down

3V3RFN is only used to supply the
negative voltage to Vss_EXT to the
antenna switches. The load is
expected to be low.

See also [05] Connectors sheet, pos B3

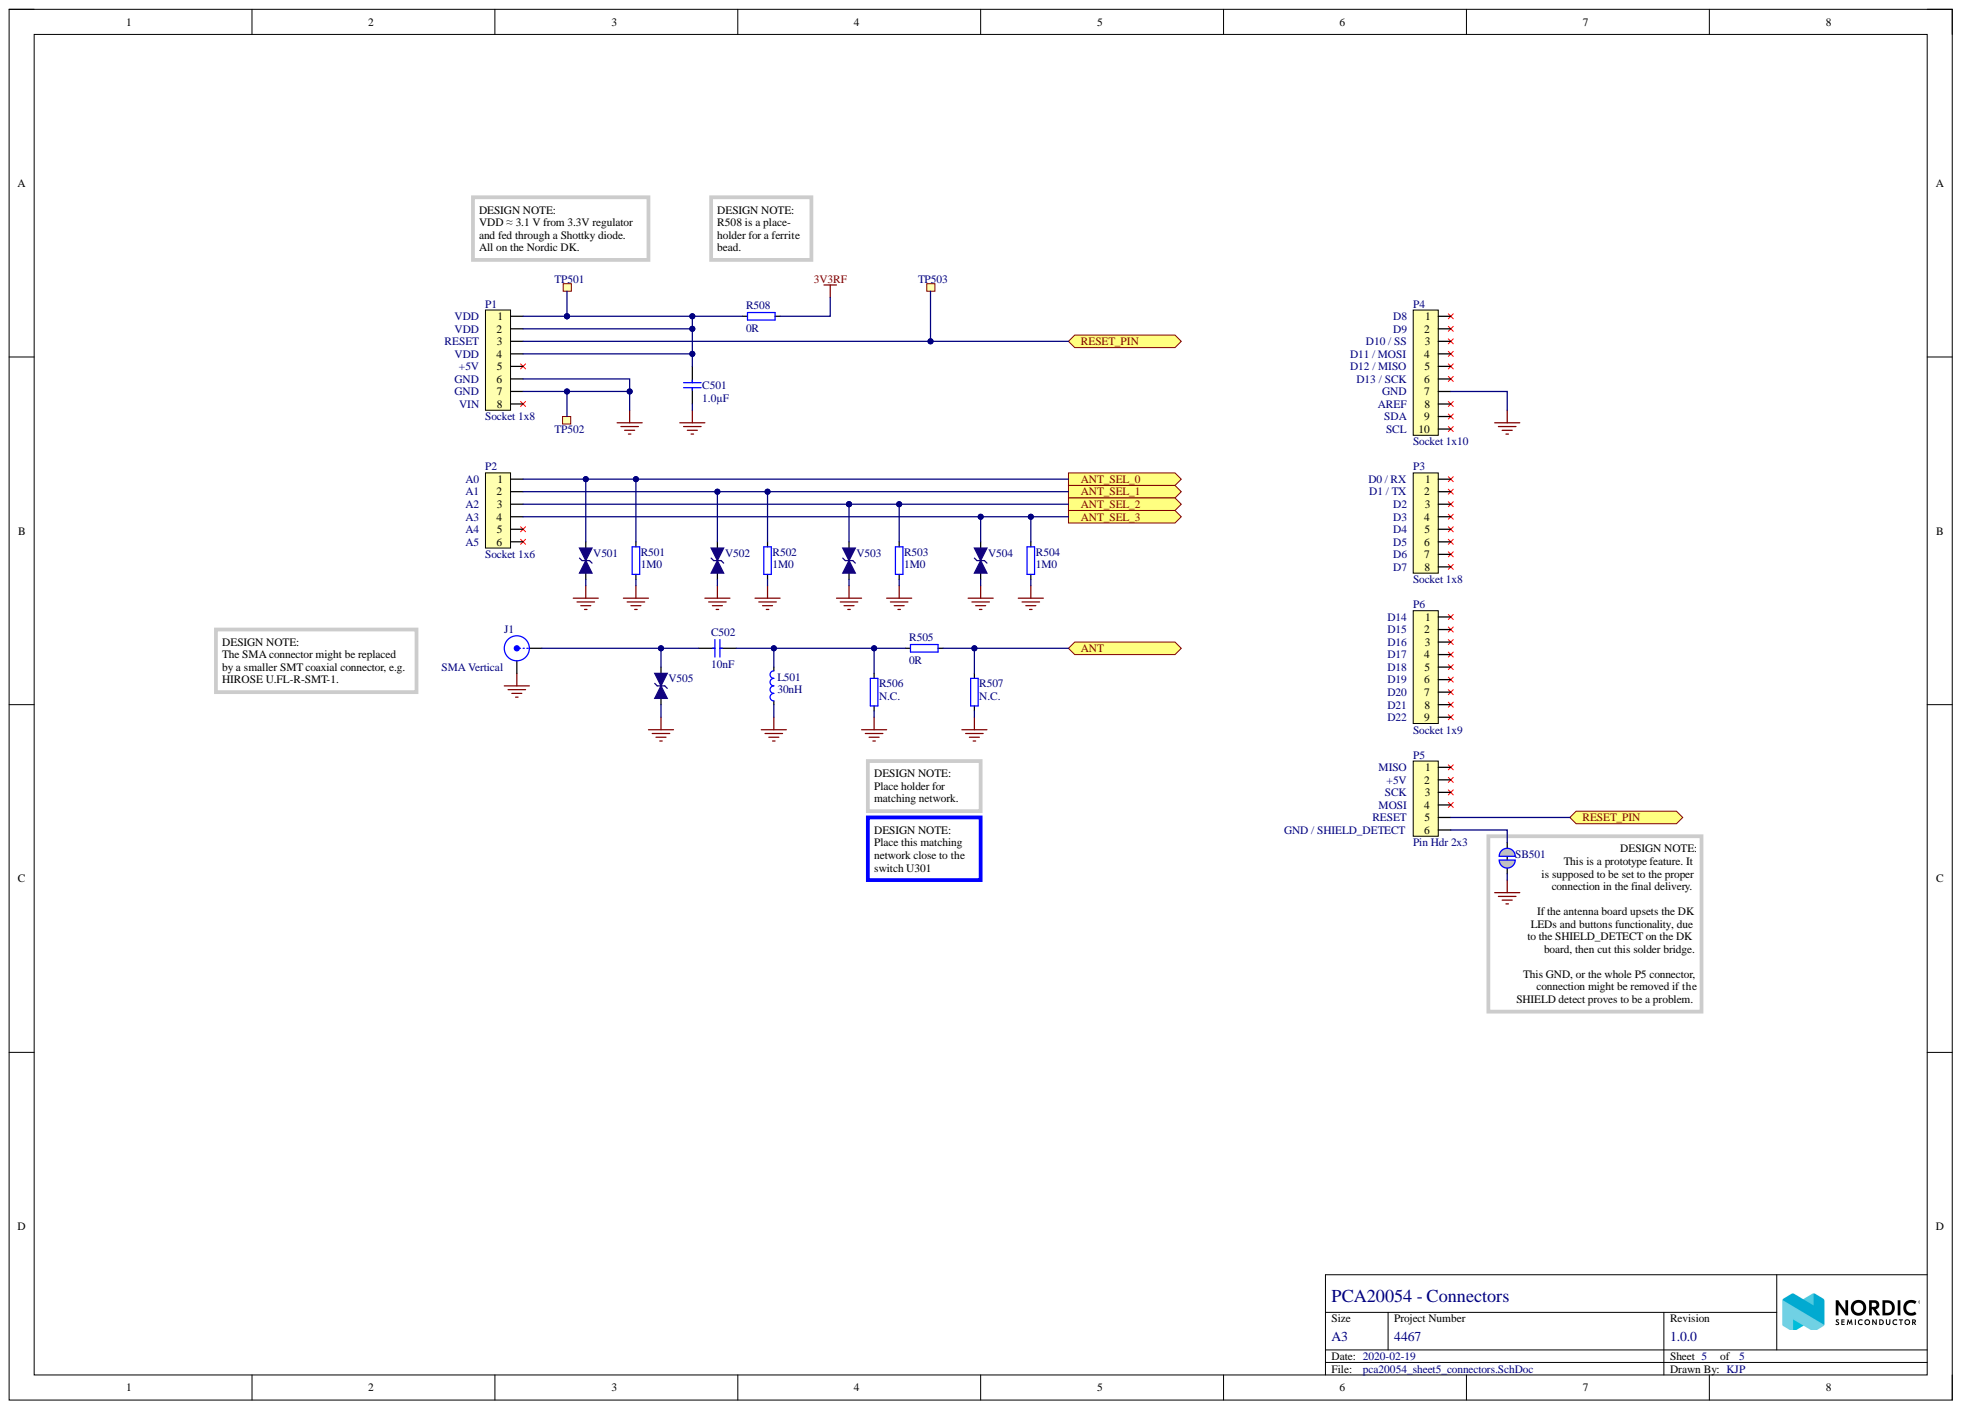
[picture p17: page 5]

DESIGN NOTE:
VDD ≈ 3.1 V from 3.3V regulator
and fed through a Shottky diode.
All on the Nordic DK.

The SMA connector might be replaced
by a smaller SMT coaxial connector, e.g.
HIROSE U.FL-R-SMT-1.

Place this matching
network close to the
switch U301

is supposed to be set to the proper
connection in the final delivery.

This is a prototype feature. It

If the antenna board upsets the DK
LEDs and buttons functionality, due
to the SHIELD_DETECT on the DK
board, then cut this solder bridge.

This GND, or the whole P5 connector,
connection might be removed if the
SHIELD detect proves to be a problem.

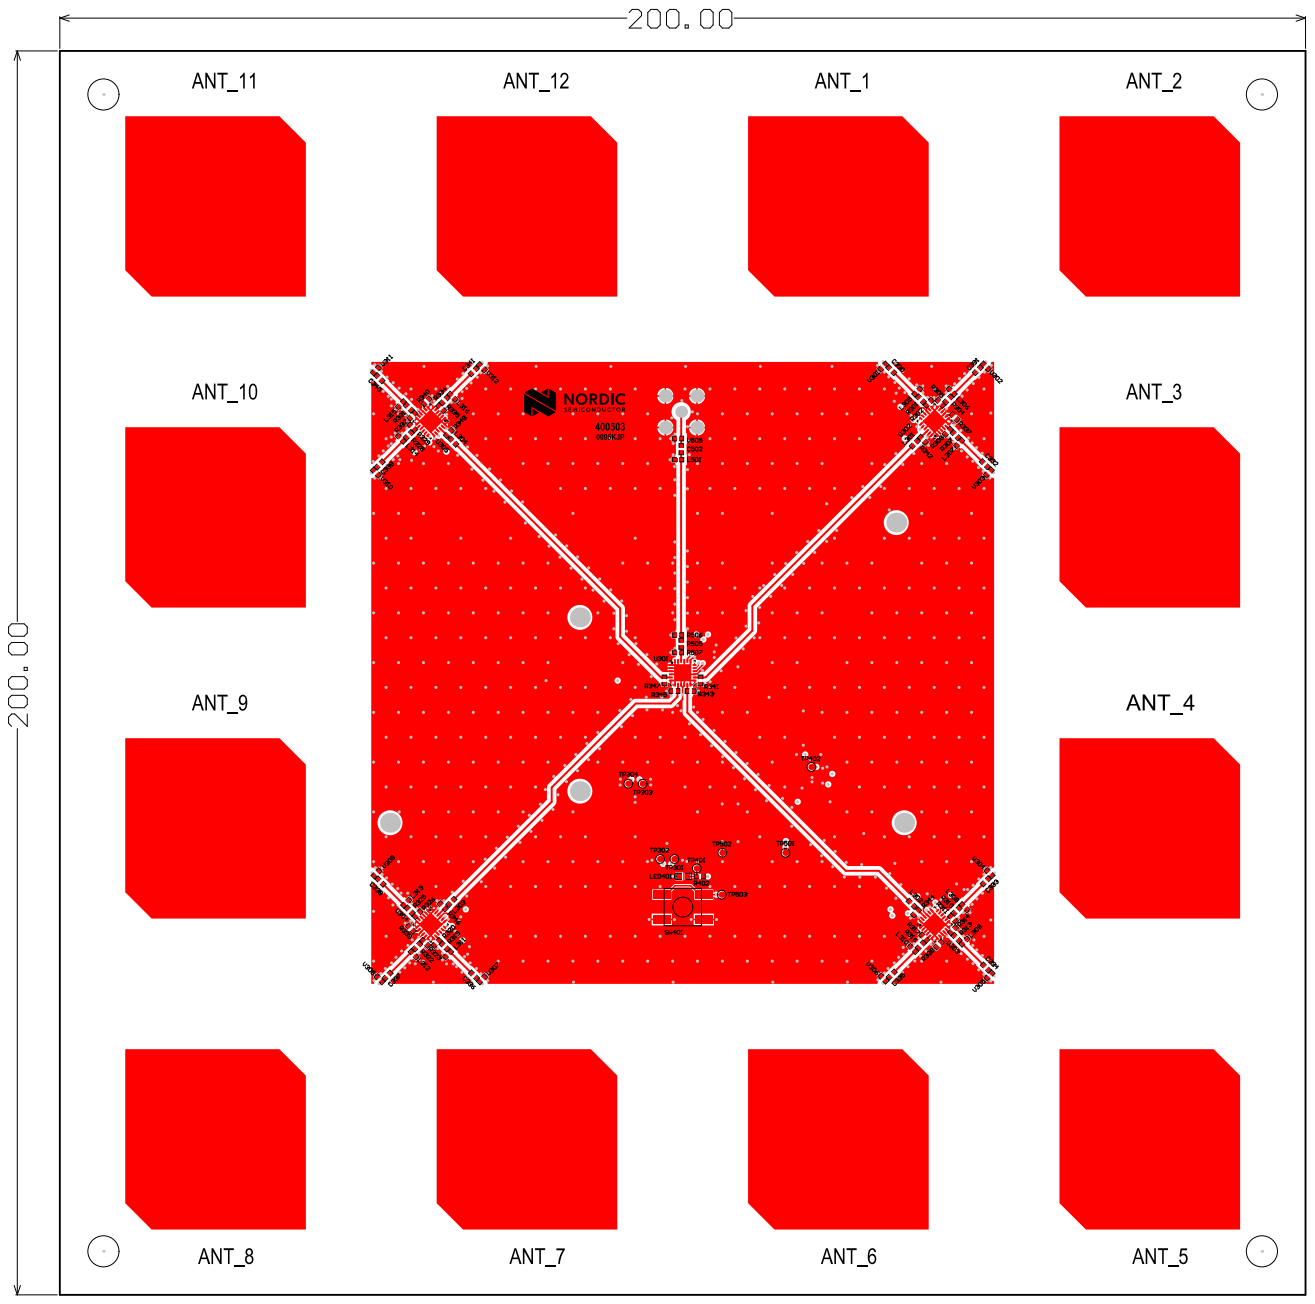
[picture p18: page 6]

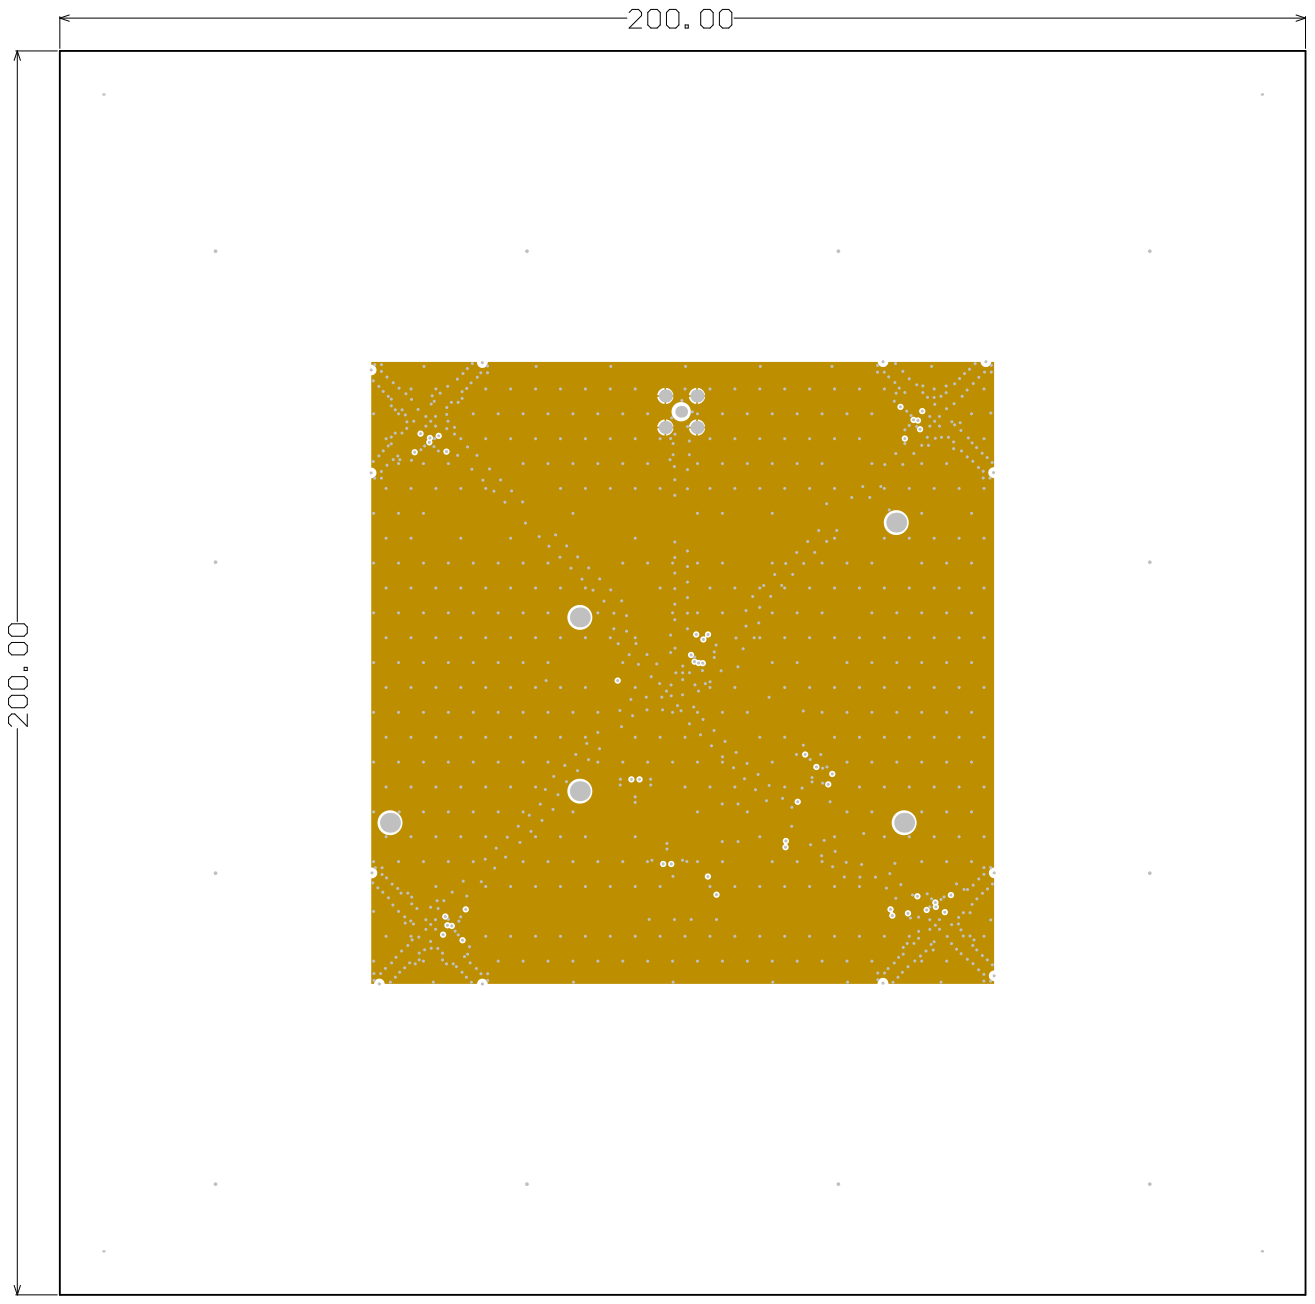
[picture p19: page 7]

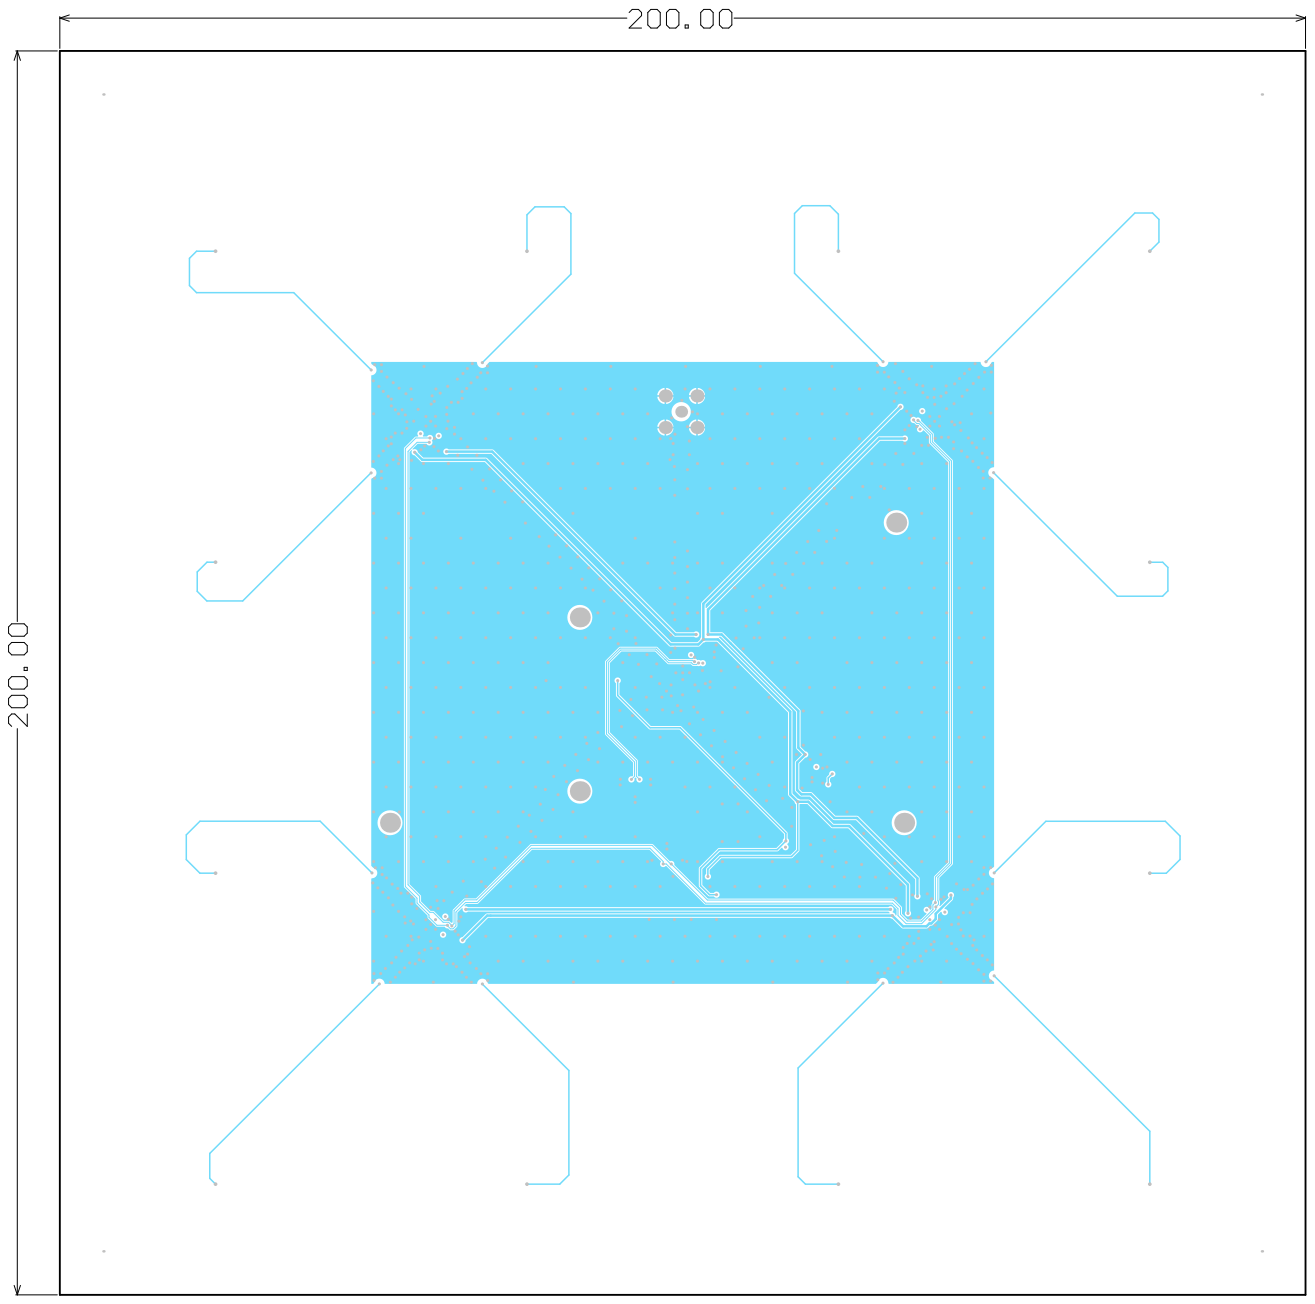
[picture p20: page 8]

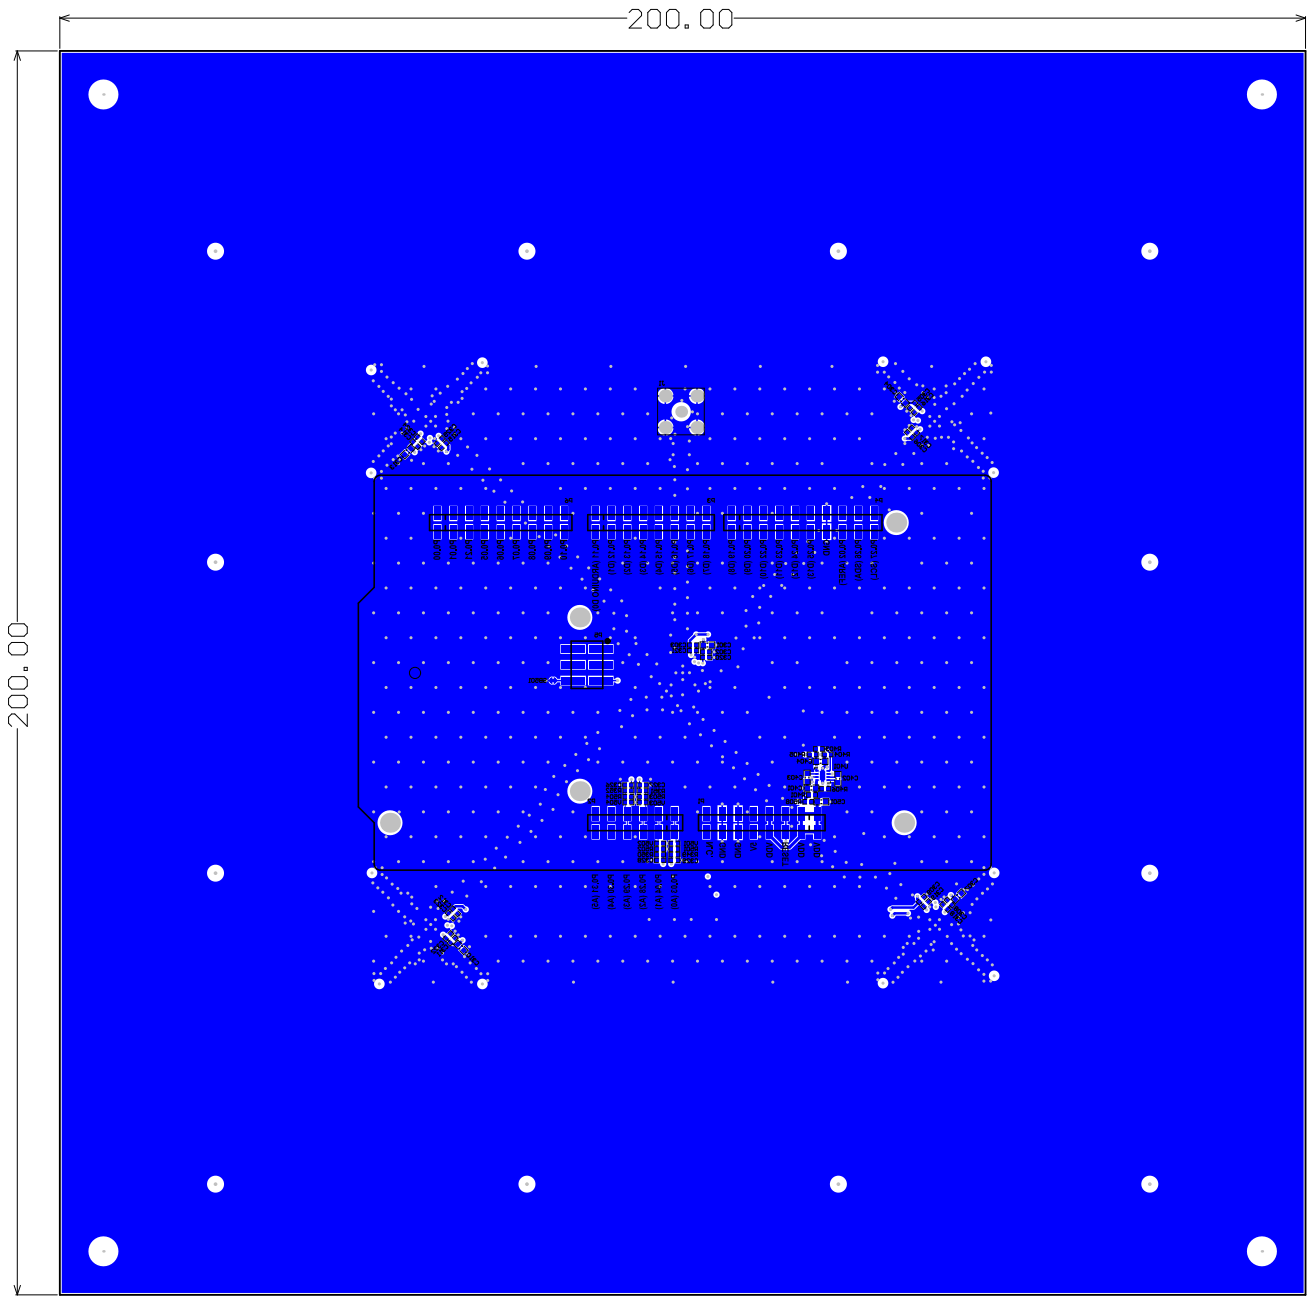
[picture p21: page 9]

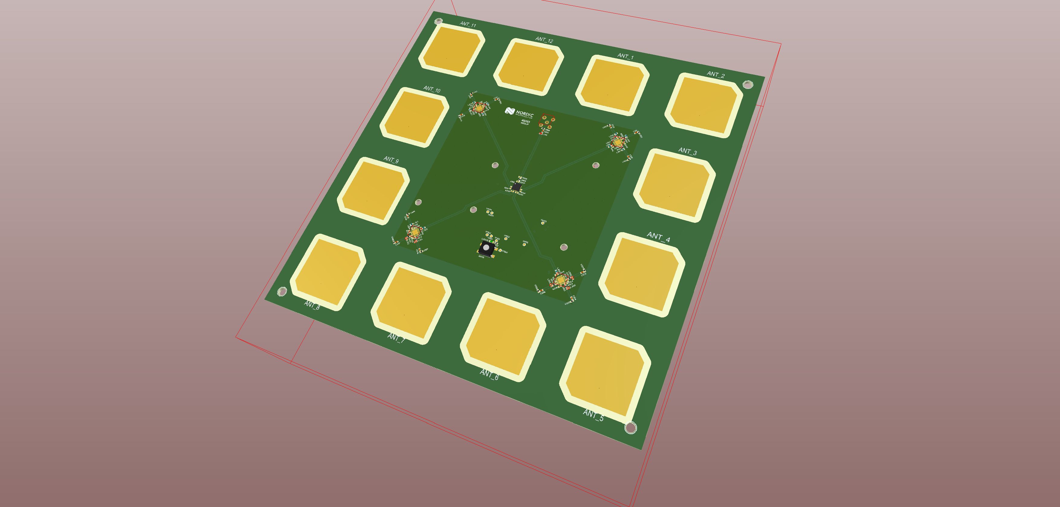
[picture p22: page 10]
