doyouemo/antenna/(list of files, drawings)

Other design files:
Hardware/PCA20054-Direction Finding Antenna Board 1_0_0/PCA20054-Direction Finding Antenna Board 1_0_0/Altium Designer files/400503.PcbDoc
Hardware/PCA20054-Direction Finding Antenna Board 1_0_0/PCA20054-Direction Finding Antenna Board 1_0_0/Altium Designer files/pca20054.PrjPCB
Hardware/PCA20054-Direction Finding Antenna Board 1_0_0/PCA20054-Direction Finding Antenna Board 1_0_0/Altium Designer files/pca20054_sheet1_cover.SchDoc
Hardware/PCA20054-Direction Finding Antenna Board 1_0_0/PCA20054-Direction Finding Antenna Board 1_0_0/Altium Designer files/pca20054_sheet2_block_diagram.SchDoc
Hardware/PCA20054-Direction Finding Antenna Board 1_0_0/PCA20054-Direction Finding Antenna Board 1_0_0/Altium Designer files/pca20054_sheet3_antenna_switches.SchDoc
Hardware/PCA20054-Direction Finding Antenna Board 1_0_0/PCA20054-Direction Finding Antenna Board 1_0_0/Altium Designer files/pca20054_sheet4_power_control.SchDoc
Hardware/PCA20054-Direction Finding Antenna Board 1_0_0/PCA20054-Direction Finding Antenna Board 1_0_0/Altium Designer files/pca20054_sheet5_connectors.SchDoc
