doyouemo/antenna/(commit log)

2026-08-10 新建了工程
2026-08-11 画了最小电路板
    [_config_tables.txt]
2026-08-15 半成品原理图
2026-08-26 把别人的参考pcb顺过来了
    [400503.DRL, 400503.GBL, 400503.GBO, 400503.GBP, 400503.GBS, 400503.GM1, 400503.GTL, 400503.GTO]
2026-09-01 步了一会板，还没连线
2026-09-07 拆了别人的天线板
2026-09-10 不做3 * 4了， 这个太大了，改成2 * 2
2026-09-27 不需要太多东西，弄干净点
2026-09-28 画了点线
2026-10-13 闲麻烦，放弃aoa
